HeinVerhallen/Hardware_Simulator/Documentation/Model Design Document/Second_Iteration_Realization.tex

The PCBs were ordered externally, and populated by the team. The boards are mounted on a aluminum plates to provide them with sufficient cooling. 3D models of the cell board and model board are visible in Fig. \ref{fig:pcb_top_cellboard}, Fig. \ref{fig:pcb_bottom_cellboard}
and Fig. \ref{fig:pcb_modelboard}.
\FloatBarrier
\begin{figure}[h]
    \centering
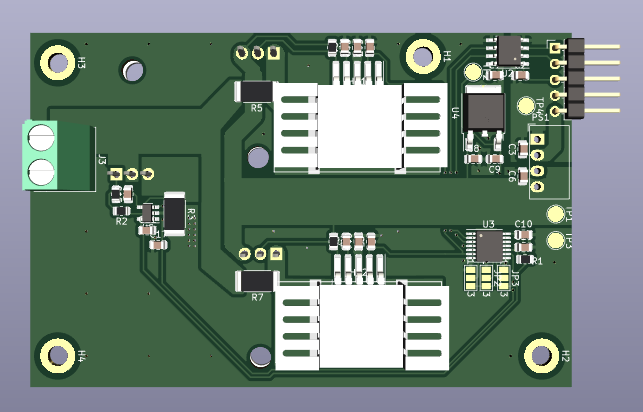
[picture p1: Documentation/Model Design Document/pcb_cell_board_top.png]
    
    \caption{PCB layout of the top of the cell board.}
    \label{fig:pcb_top_cellboard}
\end{figure}
\FloatBarrier
\begin{figure}[h]
    \centering
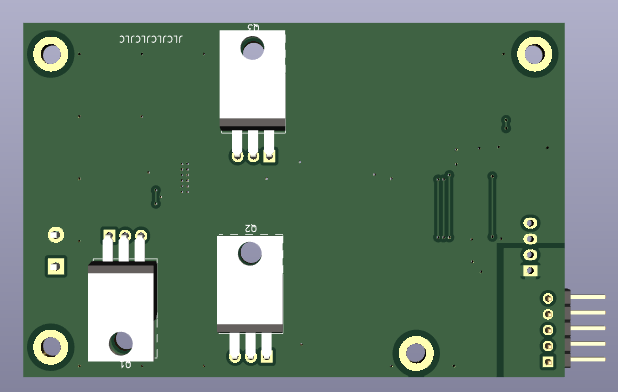
[picture p2: Documentation/Model Design Document/pcb_cell_board_bottom.png]
    
    \caption{PCB layout of the bottom of the cell board.}
    \label{fig:pcb_bottom_cellboard}
\end{figure}
\FloatBarrier
\begin{figure}[h]
    \centering
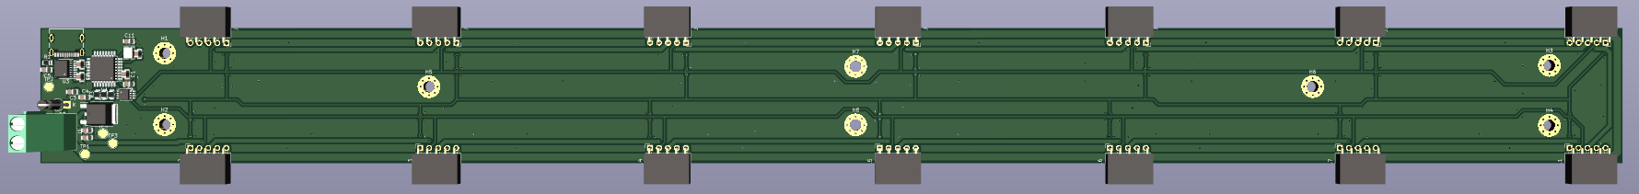
[picture p3: Documentation/Model Design Document/pcb_model_board_top.png]
    
    \caption{PCB layout of the model board.}
    \label{fig:pcb_modelboard}
\end{figure}
\FloatBarrier
