HeinVerhallen/Hardware_Simulator/Documentation/Model Design Document/First_Iteration_Hardware.tex

The first iteration board takes as an input a voltage (12 V), which
is then scaled down to 5 V to power all the on-board electronics. 
There is a USB connector and a USB interface IC, which would ensure 
being able to program the microcontroller - an ATmega328PB. For The
first iteration no software is needed, but the option was added on the 
board (with a digital potentiometer, which is explained later).

In order to make the first iteration cycle quicker and focus on 
the modular design iteration, the team included a single cell 
only in the first PCB. The cell consists of:
\begin{enumerate}
    \item A power supply section, which provides isolated 9 V and 5 V.
    \item A digital isolator - for communication for the second 
    iteration software.
    \item A high-power linear regulator - to provide the output 
    voltage, emulating discharging of the batteries.
    \item A current sink to emulate the charging of the batteries 
    consisting of an Op-Amp and a MOSFET.
    \item Potentiometers (physical but also digital ones are on 
    the board for the second iteration) - to control the voltage
    and current.
    \item Address jumpers - to distinguish each cell, when more 
    cells are added in the second iteration.
\end{enumerate}
