HeinVerhallen/Hardware_Simulator/Documentation/Model Design Document/KiCADSchematics.tex

% \FloatBarrier
\begin{figure*}[]
    \section{} \label{sec:KiCADSchematics} % For new appendix letter
    \centering
    
    \caption{Cell board full schematic.}
    \label{fig:CellBoardKiCADSchematic}
\end{figure*}

\begin{figure*}[]
    \centering
    
    \caption{Model board full schematic.}
    \label{fig:ModelBoardKiCADSchematic}
\end{figure*}
