HeinVerhallen/Hardware_Simulator/Documentation/Model Design Document/hardware_images.tex

\FloatBarrier
\begin{figure}[ht!]
    \section{}\label{sec:hardware_images}
    \centering
    
    \caption{12 A linear regulator transient response.}
    \label{fig:LT3080-1_Transient-response}
\end{figure}

\begin{figure}[ht!]
    \centering
    
    \caption{12 A linear regulator phase margin vs set point (current). The gain margin is infinite}
    \label{fig:LT3080-1_Phase-margin_VS_setpoint}
\end{figure}

\begin{figure}[ht!]
    \centering
    
    \caption{12 A linear regulator power dissipation.}
    \label{fig:LT3080-1_PowerDissipation}
\end{figure}

\begin{figure}[ht!]
    \centering
    
    \caption{12 A current sink transient response.}
    \label{fig:CurrentSinkTransient}
\end{figure}

\begin{figure}[ht!]
    \centering
    
    \caption{12 A current sink gain (blue) and fase (black) margin.}
    \label{fig:CurrentSinkPM&GM}
\end{figure}

\begin{figure}[ht!]
    \centering
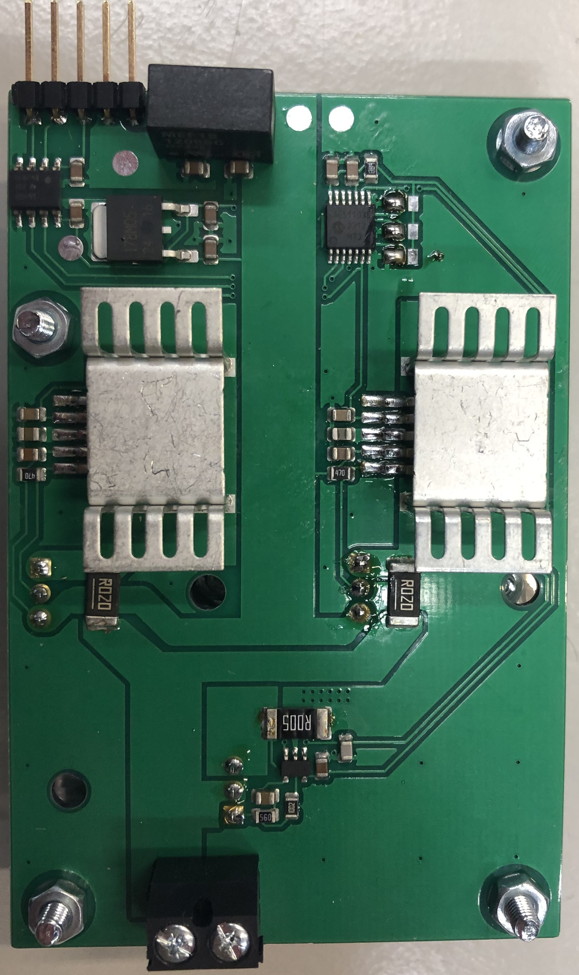
[picture p4: Documentation/Model Design Document/CellBoardTop.jpg]
    
    \caption{Top view of cell board.}
    \label{fig:CellBoardTop}
\end{figure}

\begin{figure}[ht!]
    \centering
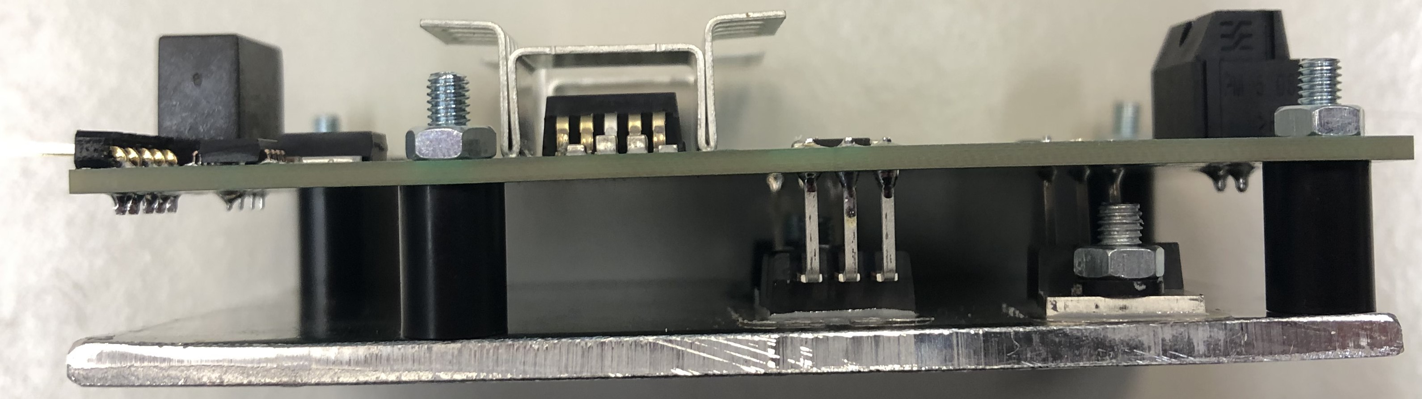
[picture p5: Documentation/Model Design Document/CellBoardSide.jpg]
    
    \caption{Side view of cell board.}
    \label{fig:CellBoardSide}
\end{figure}

\begin{figure}[ht!]
    \centering
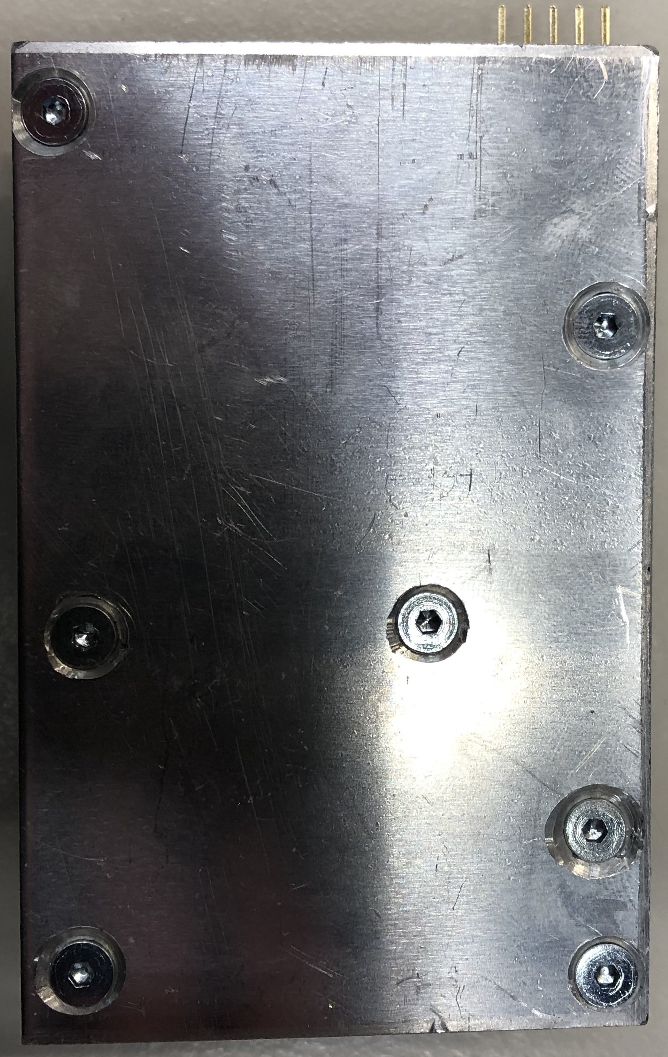
[picture p6: Documentation/Model Design Document/CellBoardBottom.jpg]
    
    \caption{Bottom view of cell board.}
    \label{fig:CellBoardBottom}
\end{figure}

\begin{figure}[ht!]
    \centering
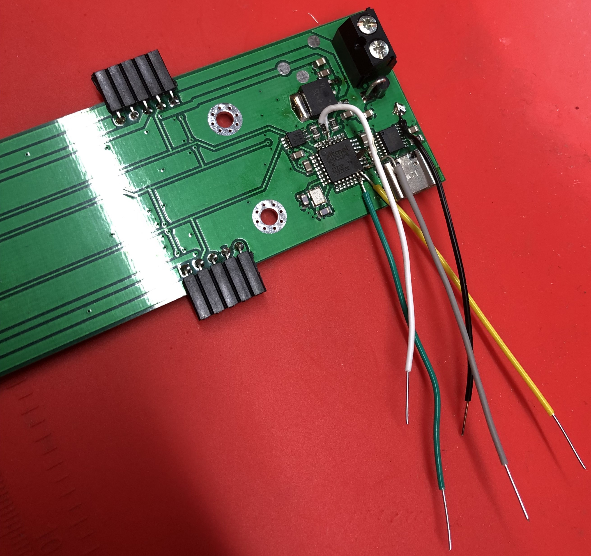
[picture p7: Documentation/Model Design Document/ModelBoardTop.jpg]
    
    \caption{Top view of model board.}
    \label{fig:ModelBoardTop}
\end{figure}

\begin{figure}[h!]
    \centering
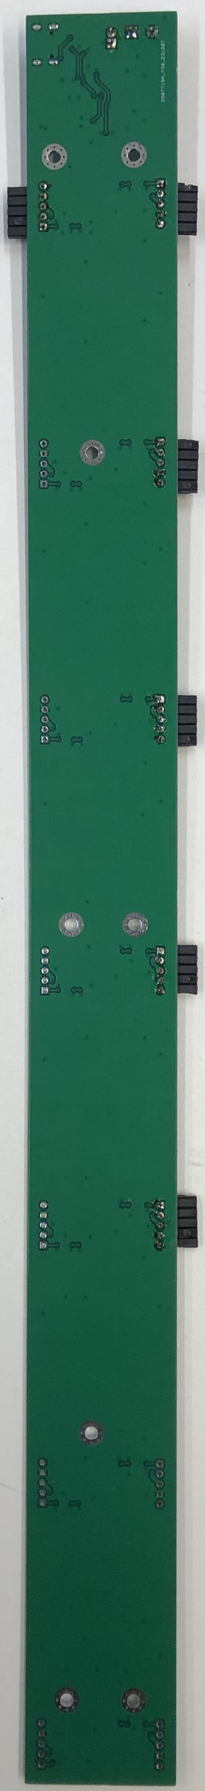
[picture p8: Documentation/Model Design Document/img/ModelBoardBottom.jpg]
    
    \caption{Bottom view of model board.}
    \label{fig:ModelBoardBottom}
\end{figure}
\FloatBarrier
