HeinVerhallen/Hardware_Simulator/Documentation/Model Design Document/First_Iteration_Architecture.tex

\begin{figure}[!th]
    \begin{center}
        
    \end{center}
    \caption{Architecture block diagram of the 1st iteration of the emulator.}
    \label{fig:1st_architecture}
\end{figure}

In Fig. \ref{fig:1st_architecture} the architecture of the first iteration 
of the battery emulator is shown.
