HeinVerhallen/Hardware_Simulator/Documentation/Model Design Document/software_flowcharts.tex

\FloatBarrier
\begin{figure}[ht!]
    \section{}\label{sec:software_flowcharts}
    \centering
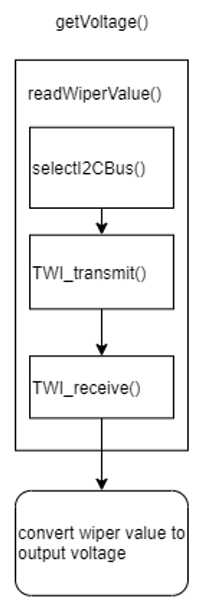
[picture p10: Documentation/Model Design Document/software_getVoltage_flow_chart.png]
    
    \caption{Flow chart of the getVoltage function.}
    \label{fig:getvoltage}
\end{figure}
\FloatBarrier
\begin{figure}[ht!]
    \centering
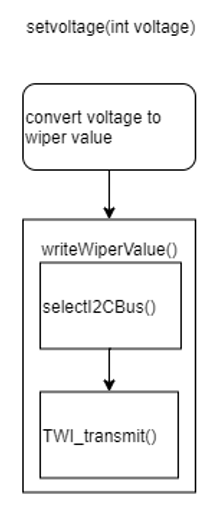
[picture p11: Documentation/Model Design Document/software_setVoltage_flow_chart.png]
    
    \caption{Flow chart of the setVoltage function.}
    \label{fig:setvoltage}
\end{figure}
\FloatBarrier
\begin{figure}[ht!]
    \centering
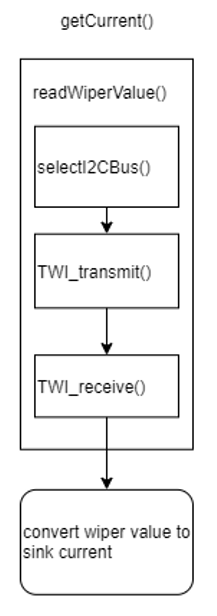
[picture p12: Documentation/Model Design Document/software_getCurrent_flow_chart.png]
    
    \caption{Flowchart of the getCurrent function.}
    \label{fig:getcurrent}
\end{figure}
\FloatBarrier
\begin{figure}[ht!]
    \centering
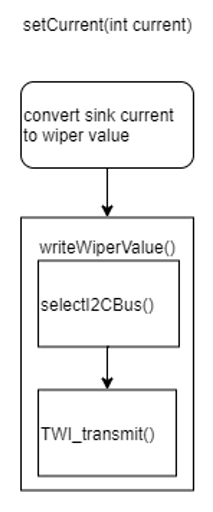
[picture p13: Documentation/Model Design Document/software_setCurrent_flow_chart.png]
    
    \caption{Flow chart of the setCurrent function.}
    \label{fig:setcurrent}
\end{figure}
\FloatBarrier
