HeinVerhallen/Hardware_Simulator/Documentation/Plan of Approach/main.tex

\documentclass[11pt, a4paper]{report}
\usepackage{graphicx}
\usepackage[table,xcdraw]{xcolor}
\usepackage{geometry}
\usepackage{float}
\usepackage{authblk}
\usepackage{anyfontsize}
\usepackage[document]{ragged2e}
\usepackage{titlesec}
\usepackage[parfill]{parskip}
\usepackage{color}   %May be necessary if you want to color links
\usepackage{hyperref}
\usepackage{caption}
\usepackage{tabularx}
\usepackage{longtable}
\usepackage{blindtext}
\usepackage{pdflscape}
\usepackage{multirow}
\usepackage{booktabs}
\hypersetup{
    colorlinks=true, %set true if you want colored links
    linktoc=all,     %set to all if you want both sections and subsections linked
    linkcolor=black,  %choose some color if you want links to stand out
}
\titleformat{\chapter}[hang] 
{\normalfont\huge\bfseries}{\chaptertitlename\ \thechapter:}{1em}{} 
\geometry{left=2.5cm,right=2.5cm,top=2.5cm,bottom=2.5cm}
\graphicspath{ {./images/} }

% Handy link: https://artofproblemsolving.com/wiki/index.php/LaTeX:Layout

% CHECK https://www.youtube.com/watch?v=ZYvS52511oQ FOR INFO ON SETTINGS FOR biblatex

\begin{document}
\pagestyle{empty}
\centering
\fontsize{2cm}{2cm}\selectfont{Plan of Approach} \\
\vspace{2mm}
\fontsize{1cm}{1cm}\selectfont Hardware Simulator \\
\vspace{2mm}
\large Project S7\\
\normalsize
\vspace{4cm}
% \includegraphics[width=\linewidth]{3DR_P1_Perspective.png}\\
\vfill
\normalsize Hein Verhallen \\
Nikola Panchev \\
Robin van den Dungen \\
Wyatt Southard \\
Youri Tils \\
Fontys Hogescholen, De Rondom 1, 5612 AP Eindhoven \\
\today

\begin{justify}

\newpage
\tableofcontents
\thispagestyle{empty}

\listoffigures
\thispagestyle{empty}

\listoftables
\thispagestyle{empty}

\newpage
\pagestyle{plain}
\setcounter{page}{1}

\chapter*{Abbreviation List}

\begin{table}[!h]
	\centering
\begin{tabular}{|c|c|}
	\hline
\textbf{Abbreviation} & \textbf{Explanation}        \\ \hline
BMS                   & Battery management system    \\ \hline
Li-ion	              & Lithium-ion    \\ \hline
\end{tabular}
\caption{List of commonly used Abbreviations}
\label{Abbreviation list}
\end{table}

\chapter{Background}
	\input{Background}

\chapter{Project result}
	\input{Projectresult}
	
\chapter{Project activities}
	\input{Projectactivities}

\chapter{Project boundaries}
	\input{Projectboundaries}
	
\chapter{Milestones}
	\input{Milestones}

\chapter{Quality assurance}
	\input{Qualityassurance}

\chapter{Project organization}
	\input{Projectorganization}

% \begin{landscape}
	\chapter{Planning}
		\input{Planning}
% \end{landscape}

\chapter{Cost-benefit overview}
	\input{Costbenefitoverview}

\chapter{Risk Analysis}
	\input{Riskanalysis}

\chapter{Appendix A: requirements}
	\input{Appendix_A_requirements.tex}

% Bibliography with heading so it pops up in the table of contents (i don't know why but this is how it works)
% \printbibliography[
% heading=bibintoc,
% title={Bibliography}
% ]
	\end{justify}
\end{document}
