HeinVerhallen/Hardware_Simulator/Documentation/Plan of Approach/Projectresult.tex

\begin{figure}[ht]
    \centering
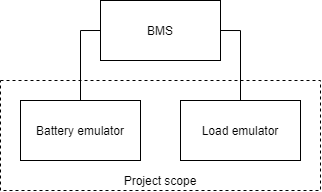
[picture p14: Documentation/images/System_context_diagram.png]
    
    \caption{System context diagram}
    \label{fig:system_context_diagram}
\end{figure}

The goal of this project is to design, built and test a battery pack emulator and (optionally) a load emulator that can be used to test a BMS (see figure \ref{fig:system_context_diagram}). This battery pack emulator should in the first design iteration be capable of emulating a battery pack with Li-ion cell characteristics. In order to emulate a Li-ion cell correctly it should be possible to emulate both charging and discharging of the Li-ion cell. 

Because the project team members are not yet experts in the field of designing battery pack emulators for BMS testing, it is chosen to design the battery pack emulator in iterations. In the first design iteration a battery pack emulator circuit will be designed which emulates the characteristics of a Li-ion battery pack. This battery pack emulator consists of two Li-ion cell emulators which are capable of charging and discharging. The voltages of each emulated cell are adjusted by a mechanical variable resistor. Each emulated cell has a voltage and current range that is 20\% larger than the safe operating area of a Li-ion cell.

In the second design iteration software will be added to the battery emulator circuit to control the voltages of each emulated cell via software. Also the temperature will be emulated in the battery pack emulator. The third design iteration consists of expanding the amount of emulated cells in the emulated battery pack to 14 cells. In the fourth design iteration a load emulator will be designed to test the BMS under different load conditions. This load emulator is capable of emulating electronics and motors. 

At the end of the project it is expected that a battery pack emulator and optionally a load emulator is delivered. And if the planning allows it, a research report on existing battery and load emulators and the requirements for future battery and load emulators is delivered.

\section{Research questions}
In order to acquire functional requirements the following research questions have been derived:

\begin{itemize}
    \item What is the safe operating area for Li-ion cells?
    \item How do existing battery emulators work?
    \item How do existing load emulators work?
\end{itemize}

\section{Requirements}
For this project the following non-functional requirements with their functional requirements have been specified (see figure \ref{fig:functional_and_non-functional_requirements} in Appendix). These requirements can be changed according to research results.
