HeinVerhallen/Hardware_Simulator/Documentation/Plan of Approach/Projectactivities.tex

This chapter will detail the activies that will take place during the project and are listed below. 

\begin{enumerate}
    \item Planning 
    \item Documenting
    \item 1st Iteration of Emulator
    \item 2nd Iteration of Emulator
    \item 3rd Iteration of Emulator
    \item 4th Iteration of Emulator
\end{enumerate}

\begin{itemize}
    \item Documenting
    \begin{itemize}
    \item Create SRD
    \item Create SDD
    \item Create MDD
    \item Create research paper on the created emulator 
    \item Create a research paper on existing emulators(optional)
    \end{itemize}

    \item 1st Iteration of Emulator
    \begin{itemize}
        \item Designing
        \begin{itemize}
            \item Research existing battery emulators 
            \item Research characteristics of lithium battery cells 
            \item Integrate results from research
        \end{itemize}
        \item Realization
        \begin{itemize}
            \item Create PCB
        \end{itemize}
        \item Testing
        \begin{itemize}
            \item Verify battery emulator
        \end{itemize}
    \end{itemize}

    \item 2nd Iteration of Emulator
    \begin{itemize}
        \item Designing 
        \begin{itemize}
            \item Design hardware
            \begin{itemize}
                \item Research different cell topolgies 
                \item Research different capacity behaviors 
                \item Research different chemistry behaviors
            \end{itemize}
            \item Design firmware
        \end{itemize}
        \item Realization
        \begin{itemize}
        \item Create PCB
        \item Program PCB
        \end{itemize}
        \item Testing
        \begin{itemize}
            \item Verify hardware
            \item Verify software 
            \begin{itemize}
                \item Verify capacity behavior changes
                \item Verify chemistry behavior changes
            \end{itemize}
        \end{itemize}
    \end{itemize}

    \item 3rd Iteration of Emulator 
    \begin{itemize}
        \item Designing 
        \begin{itemize}
            \item Design hardware
            \begin{itemize}
                \item Add 12 cells
            \end{itemize}
        \end{itemize}
        \item Realization
        \begin{itemize}
        \item Create PCB
        \item Program PCB
        \end{itemize}
        \item Testing
        \begin{itemize}
            \item Verify hardware
            \item Verify software 
        \end{itemize}
    \end{itemize}

    \item 4th Iteration of Emulator (optional)
    \begin{itemize}
        \item Designing 
        \begin{itemize}
            \item Design hardware
            \begin{itemize}
                \item Research different load behaviors 
            \end{itemize}
            \item Design Firmware
            \begin{itemize}
                \item Control load emulator
            \end{itemize}
        \end{itemize}
        \item Realization
        \begin{itemize}
        \item Create PCB
        \item Program PCB
        \end{itemize}
        \item Testing
        \begin{itemize}
            \item Verify hardware
            \item Verify software 
            \begin{itemize}
                \item Verify load behavior changes
                \item Verify communication between load and emulator
                \end{itemize}
        \end{itemize}
    \end{itemize}

\end{itemize}
