HeinVerhallen/Hardware_Simulator/Documentation/Plan of Approach/Milestones.tex

\begin{enumerate}
    \item Reports
    \begin{enumerate}
        \item SRD
        \item SDD
        \item MDD
        \item Final research paper on created module
        \item Research paper on existing battery emulators
    \end{enumerate}
    \item Designs
    \begin{enumerate}
        \item Hardware Designs
        \begin{enumerate}
            \item 1st iteration of battery emulator with 2 cells based on the NXP model
            \item 2nd iteration of battery emulator including digital battery control 
            \item 3rd iteration of battery emulator including 12 additional cells 
            \item 4th iteration of battery emulator including a load emulator
        \end{enumerate}
        \item Firmware Designs
        \begin{enumerate}
            \item Battery emulator firmware of the 2nd iteration
            \item Load emulator firmware (optional)
        \end{enumerate}
    \end{enumerate}
    \item Realizations
    \begin{enumerate}
        \item Hardware
        \begin{enumerate}
            \item PCBs
        \end{enumerate}
        \item Firmware
        \begin{enumerate}
            \item Program battery emulator
            \item Program load emulator (optional)
        \end{enumerate}
    \end{enumerate}
\end{enumerate}
