HeinVerhallen/Hardware_Simulator/Documentation/Mid-term_presentation/Mid-term_presentation.pptx

## BMS-tester S7

Hein Verhallen, Nikola Panchev, Robin van den Dungen, Wyatt Southard & Youri Tils

## Contents

## …

## Questions
