HeinVerhallen/Hardware_Simulator/Documentation/Model Design Document/img/classDiagram.pdf

CellEmulator

+ Voltage: double
+ Current: double
+ I2Cbus: uint8_t
+ potAddress1: uint8_t
+ potAddress2: uint8_t

Public:
+ constructor(uint8_t, uint8_t) + getVoltage(): double
+ getCurrent(): double
+ setVoltage(double): int
+ setCurrent(double): int
Private:
+ writeWiperValue(uint8_t,uint8_t) + selectI2Cbus(): void
