HeinVerhallen/Hardware_Simulator/Planning Hardware emulator.xlsx

 |  |  |  |  |  | Project week number
Project phase | Task | Sub task | Assigned to 1 | Assigned to 2 | Progress | 1 | 2 | 3 | 4 | 5 | 6 | 7 | 8 | 9 | 10 | 11 | 12 | 13 | 14 | 15 | 16 | 17 | 18 | 19 | 20 | Current week | 28
Documentation | PoA |  | Everyone
Documentation | SRD |  | Everyone
Documentation | SDD |  | Everyone
Documentation | MDD |  | Everyone
Research | Researching | Research different cell topologies
Research | Researching | Research different capacity behaviors
Research | Researching | Research different chemistry behaviors
Research | Researching
Research | Researching
Research | Researching
Research | Researching
Research | Researching
Research | Researching
Research | Researching
Architecture
Architecture
Architecture
Architecture
Architecture
Architecture
Architecture
Development
Development
Development
Development
Development
Development
Development
Development
Development
Development
Development
Development
Development
Development
Development
Development
Development
Development
Development
Development
Development
Development
Development
Development
Development
Development
Development
Development
Development
Development
Development
Assembly
Assembly
Assembly
Assembly
Assembly
Validation
Validation
