HeinVerhallen/Hardware_Simulator/Documentation/Plan of Approach/Functional and non-functional requirements.xlsx

NF ID | Non-functional | Design iteration | F ID | Functional
1 | Battery pack emulator is able to emulate Li-ion characteristics | 1 | 1.1 | The maximum voltage of the battery pack emulator is 80V
 |  |  | 1.2 | The battery pack emulator has a peak power of 13.44kW (see 10.1)
 |  |  | 1.3 | The battery pack emulator has a continuous power of 112W (see 10.1)
2 | Battery pack emulator consists of two emulated Li-ion cells | 1 | 2.1 | The first iteration of the battery pack emulator consists of two emulated Li-ion cells
3 | Battery pack emulator is able to emulate charging and discharging of Li-ion cell | 1 | 3.1 | The emulated cell is able to deliver current (see 5.2 and 5.3)
 |  |  | 3.2 | The emulated cell is able to sink current (see 5.4 and 5.5)
 |  |  | 3.3 | A linear regulator is used to generate the specified voltages (see 5.1)
4 | The voltages of each emulated cell can be adjusted separately via hardware | 1 | 4.1 | The cell voltages can be changed by a mechanical variable resistor
5 | Each emulated cell has a voltage and current range that is 20% larger than the safe operating area of a Li-ion cell | 1 | 5.1 | The emulated cell has a voltage range of 2.48 to 5.04 V
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
