HeinVerhallen/Hardware_Simulator/Documentation/Plan of Approach/Appendix_A_requirements.tex

\begin{figure}[ht!]
    \centering
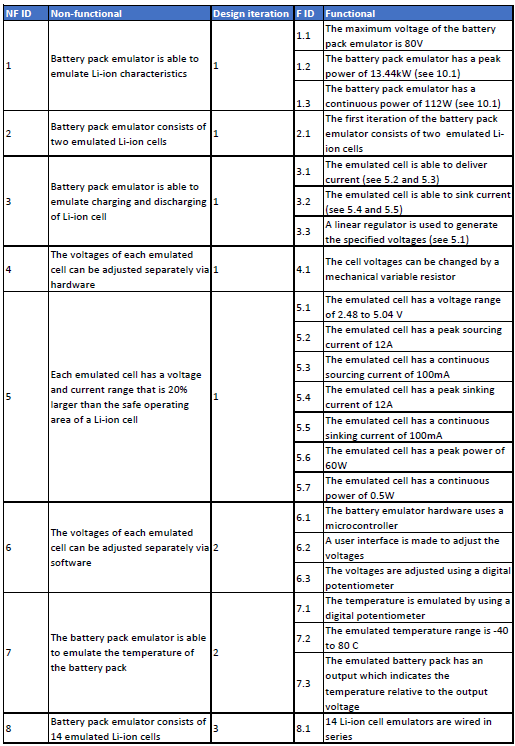
[picture p21: Documentation/Plan of Approach/images/Functional_non-functional_requirements_p1.png]
    
\end{figure}
\newpage

\begin{figure}[ht!]
    \centering
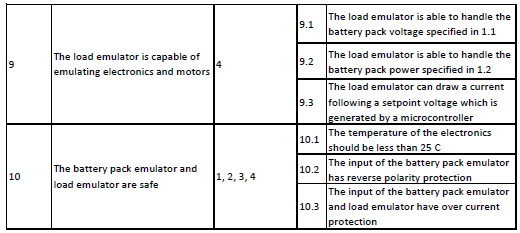
[picture p22: Documentation/Plan of Approach/images/Functional_non-functional_requirements_p2.png]
    
    \caption{Functional and non-functional requirements}
    \label{fig:functional_and_non-functional_requirements}
\end{figure}
