HeinVerhallen/Hardware_Simulator/Documentation/Plan of Approach/Planning.tex

\begin{figure}[ht!]
    \centering
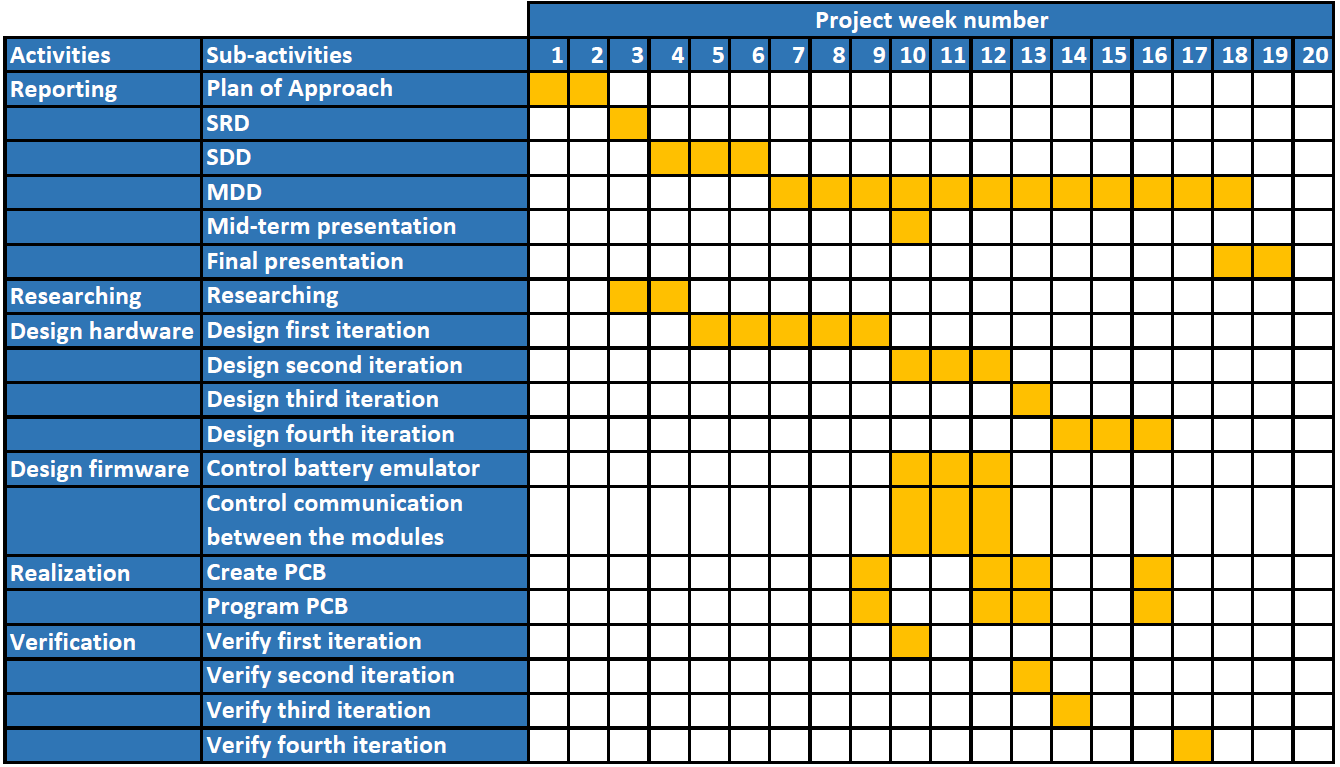
[picture p23: Documentation/Plan of Approach/images/Broad_planning.png]
    
    \caption{planning}
    \label{tab:planning}
\end{figure}
