HeinVerhallen/Hardware_Simulator/Documentation/Plan of Approach/Qualityassurance.tex

For good quality deliverables it is necessary that all team members are using the same tools and environments. Therefore the tools and environments are listed down below:

The documentation will be written in LaTeX using the following tools:
\begin{itemize}
    \setlength\itemsep{-0.3em}
    \item The editor will be VSCode.
    \item The compiler will be MiKTeX
\end{itemize}

The coding will be done using the following tools:
\begin{itemize}
    \item VSCode
    \item PlatformIO extension
\end{itemize}

The design and simulation of electronic circuits will be made using the following tools:
\begin{itemize}
    \item LTspice for simulation
    \item Altium for PCB design
\end{itemize}

In order to make sure that everyone can work simultaneously on documents and code the team wil utilize Git with an online repository hosted on GitHub.
