HeinVerhallen/Hardware_Simulator/Simulations/Linear-regulator/Period1/Ananlyse_PREG.docx

V1:

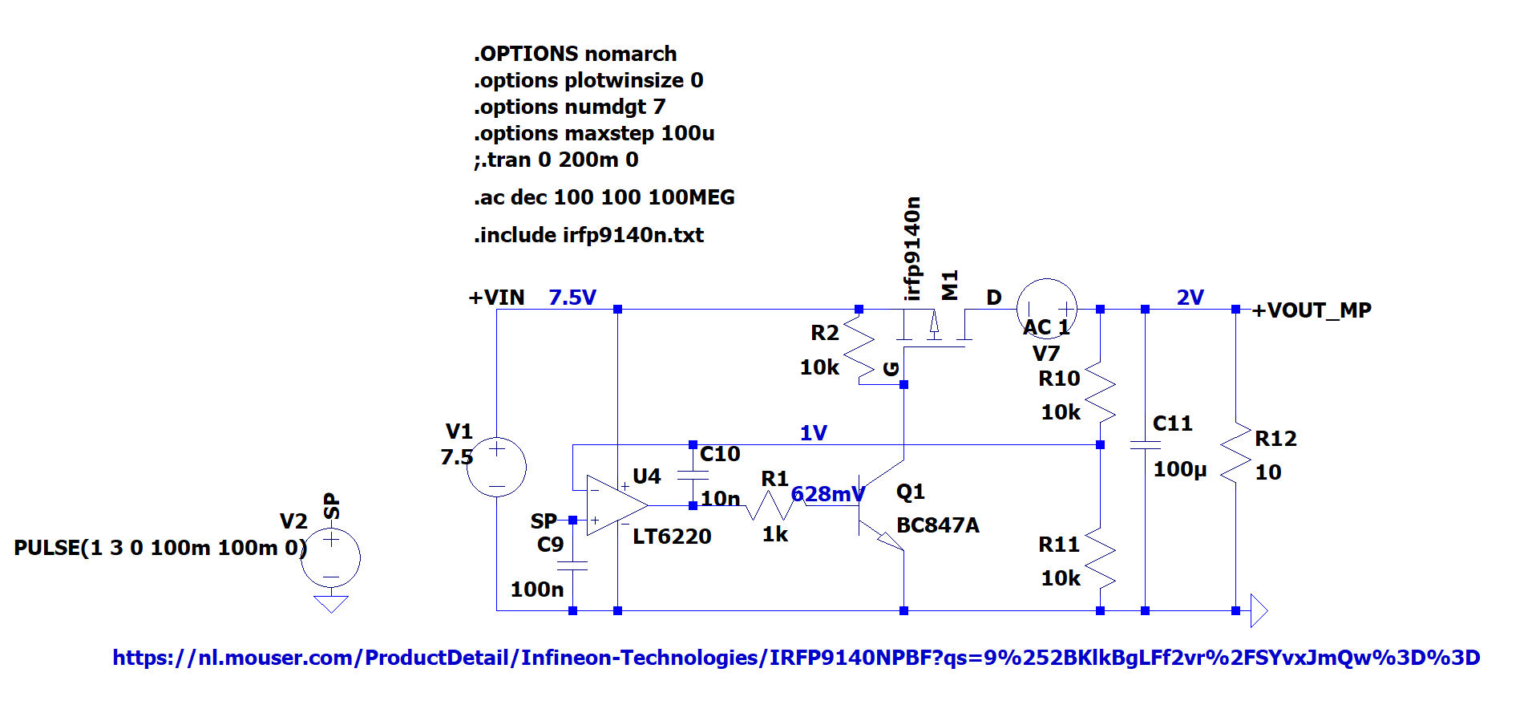
[picture p24: figure]
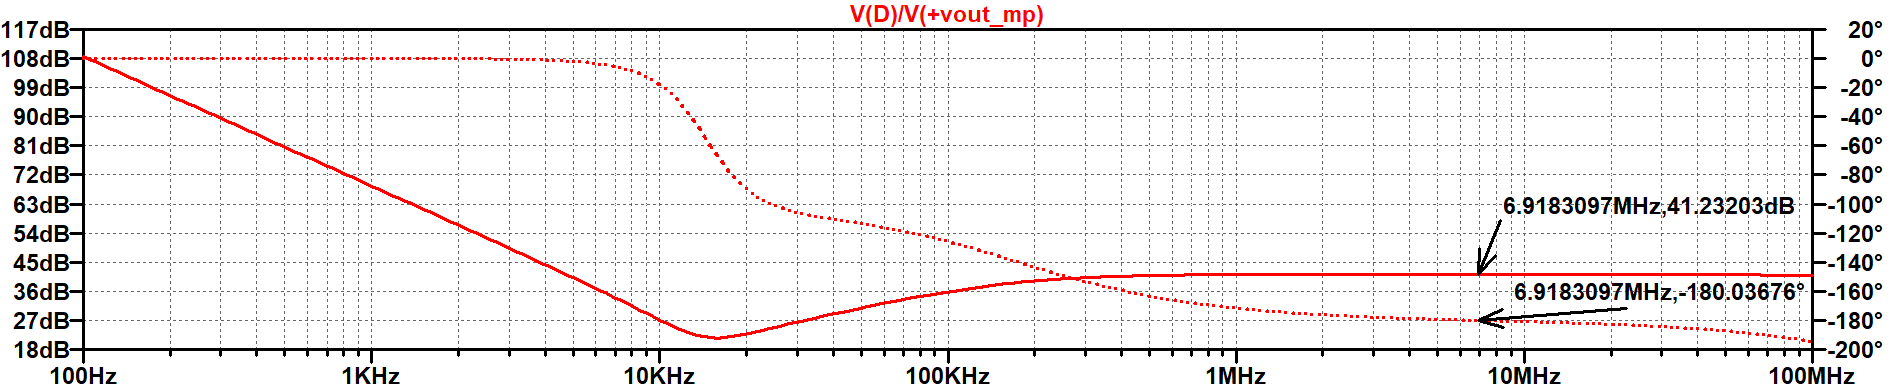
[picture p25: figure]

V2:

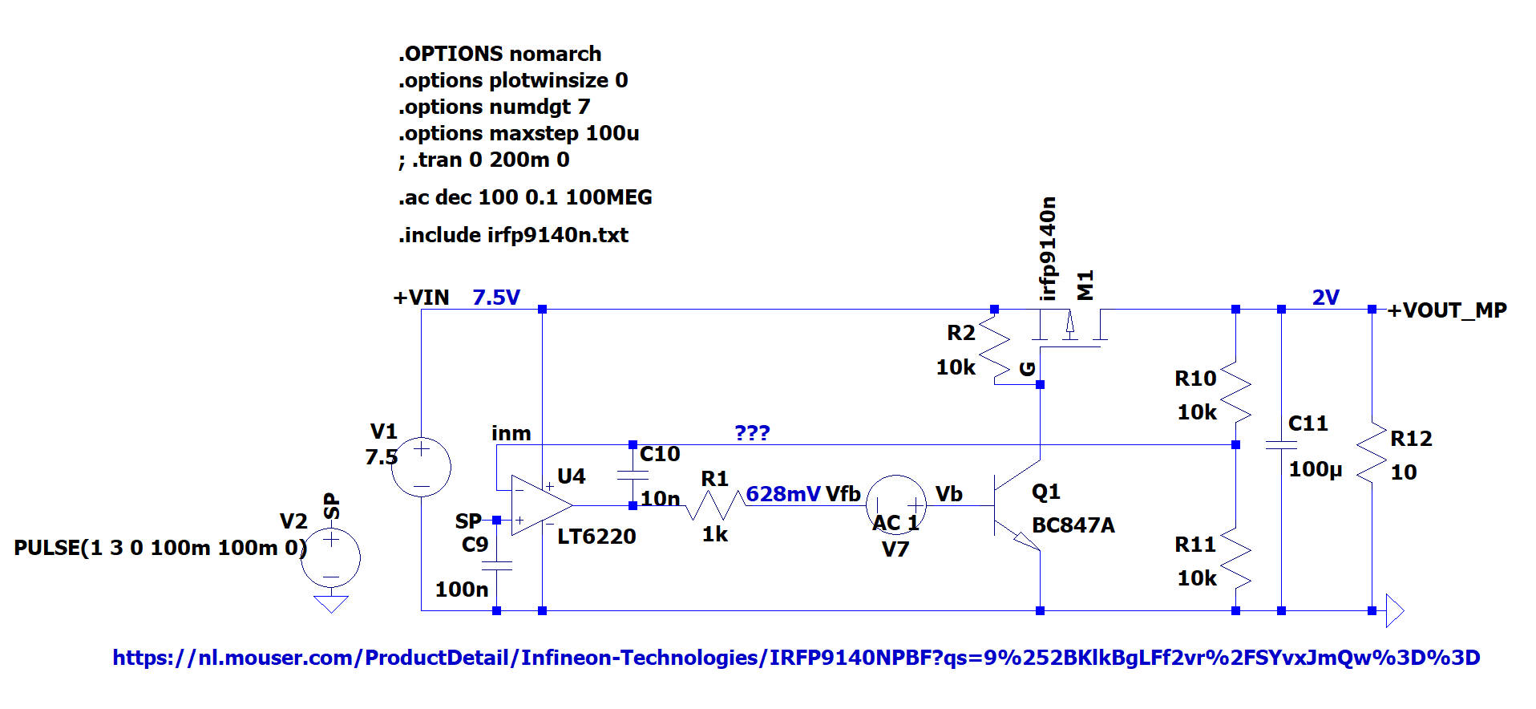
[picture p26: figure]
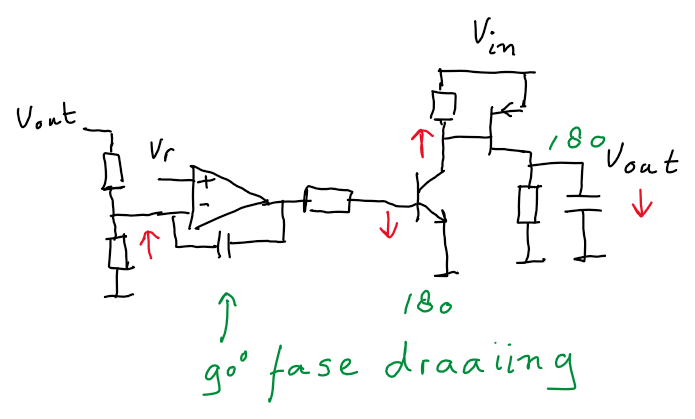
[picture p27: figure]
C:\Users\882920\AppData\Local\Microsoft\Windows\INetCache\Content.MSO\7C2EDA0D.tmp
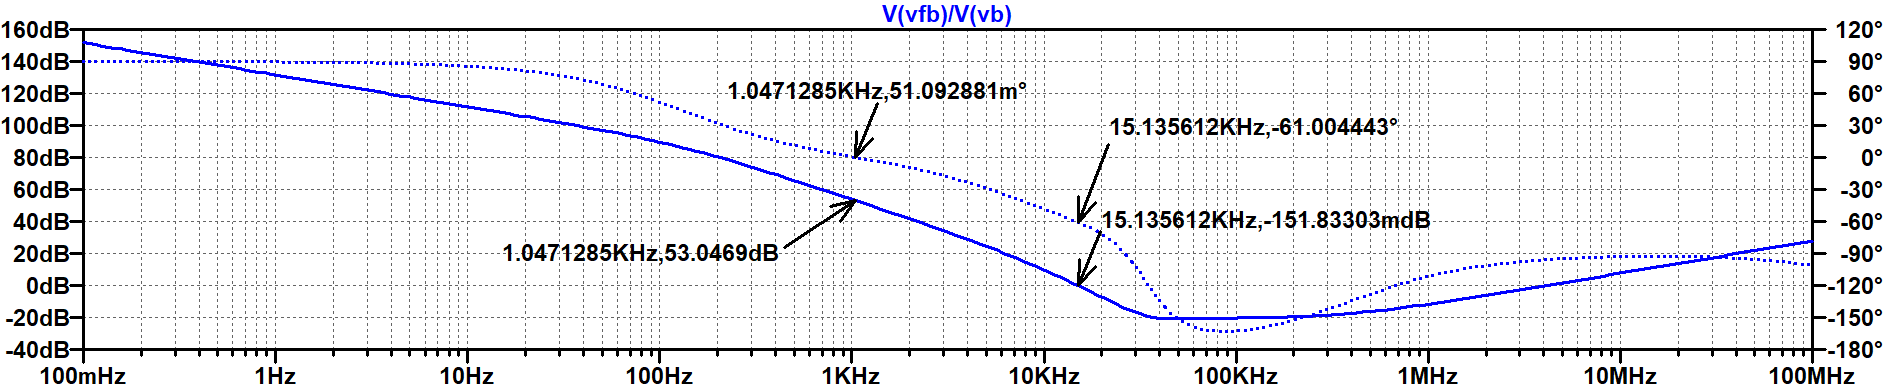
[picture p28: figure]

Verschillende tussen overdrachten:

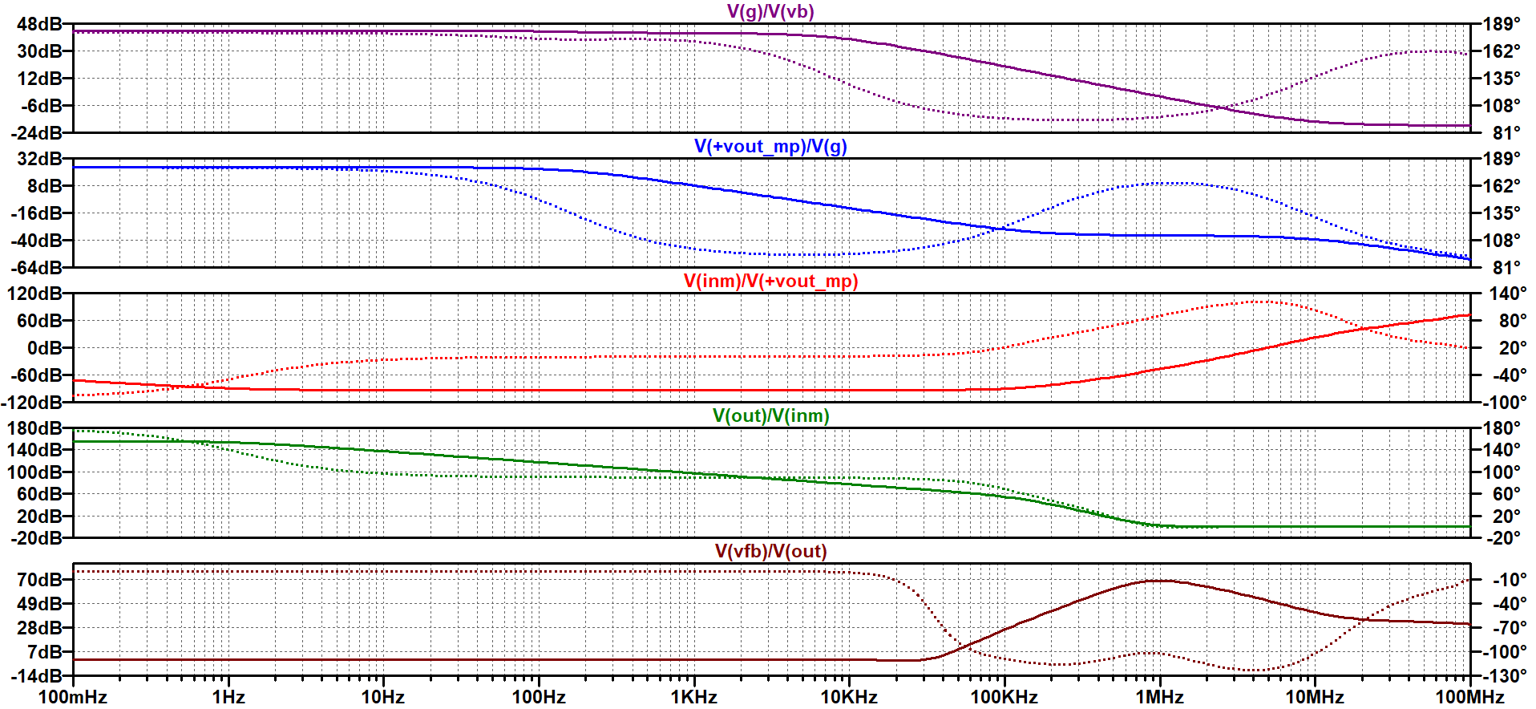
[picture p29: figure]

V(out)/V(inm) is dominant, daarna V(+vout_mp)/V(g) en vervolgens V(g)/V(vb).

3e orde, te veel fase draaiing.

V3: Zonder C10

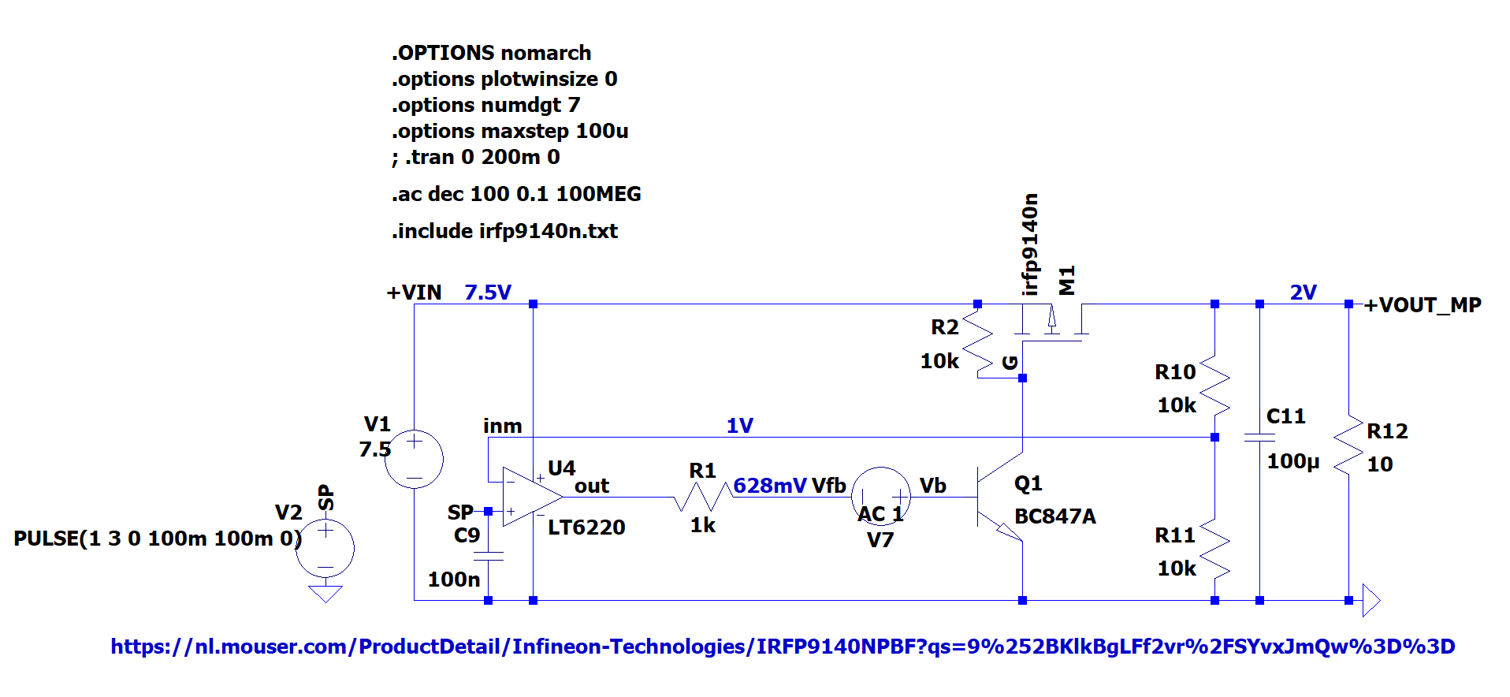
[picture p30: figure]
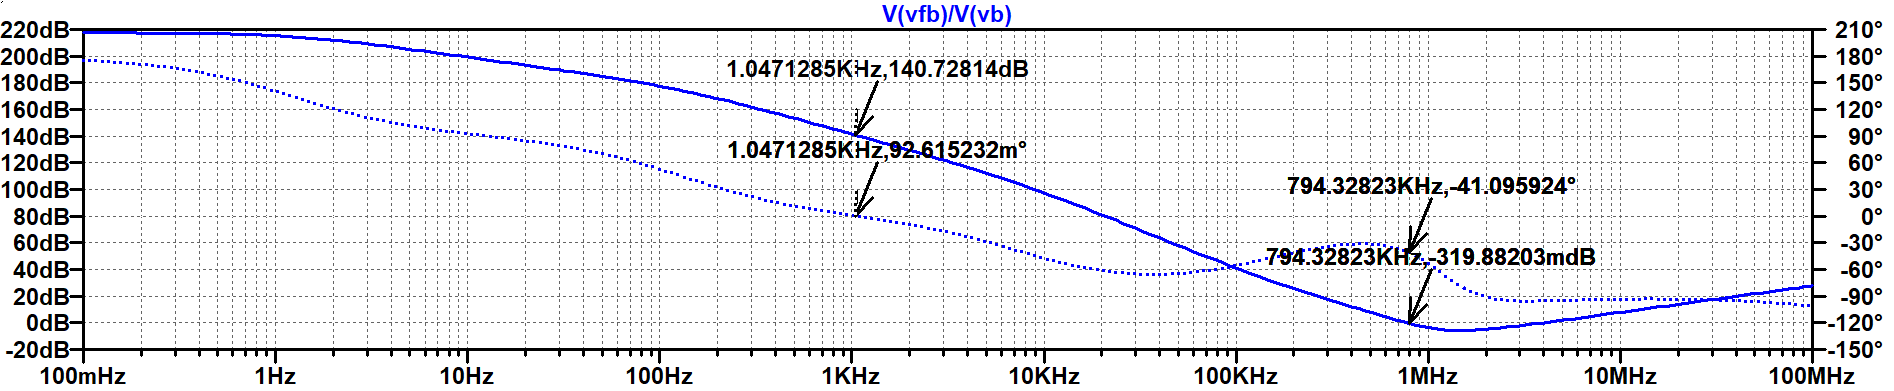
[picture p31: figure]

Te veel loopgain.

Verschillende tussen overdrachten:

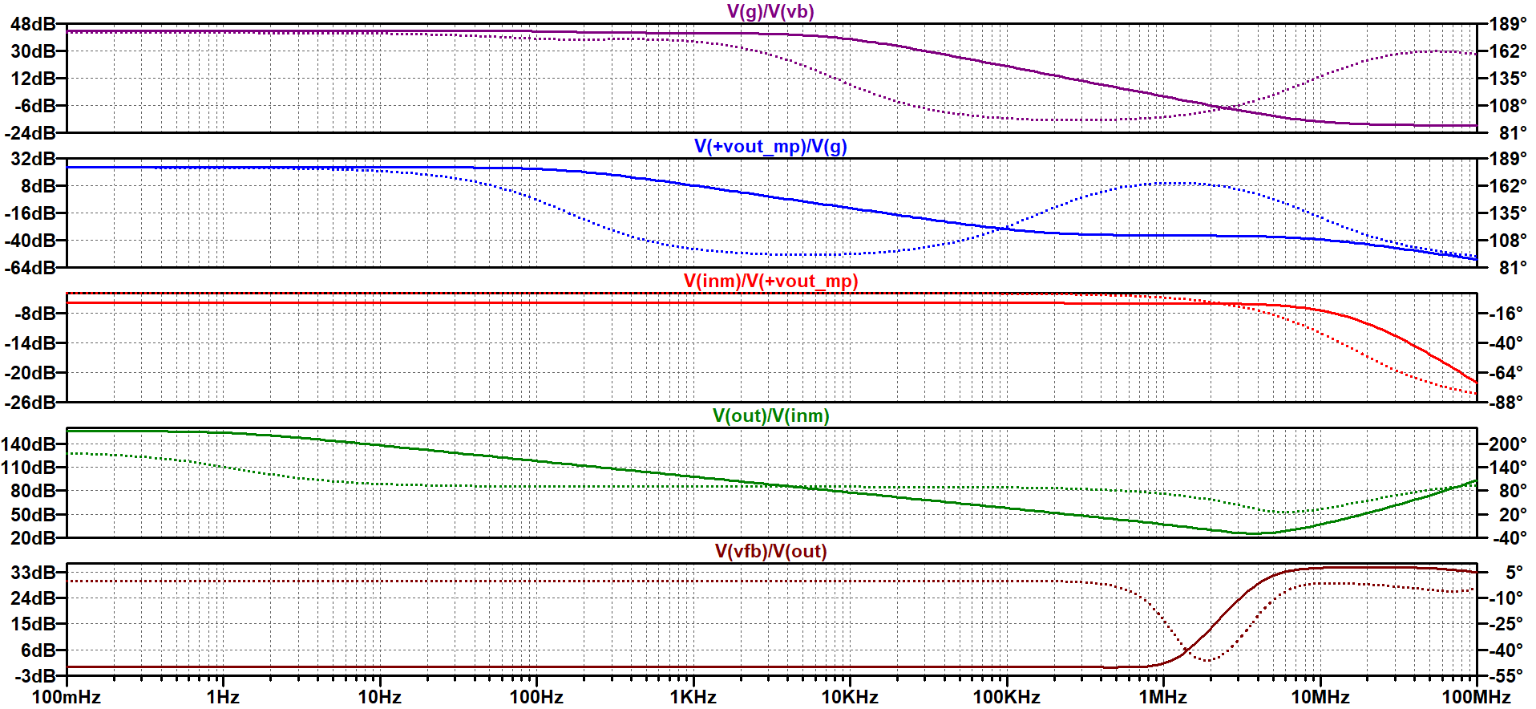
[picture p32: figure]

V4:

Transistor verwijderd.

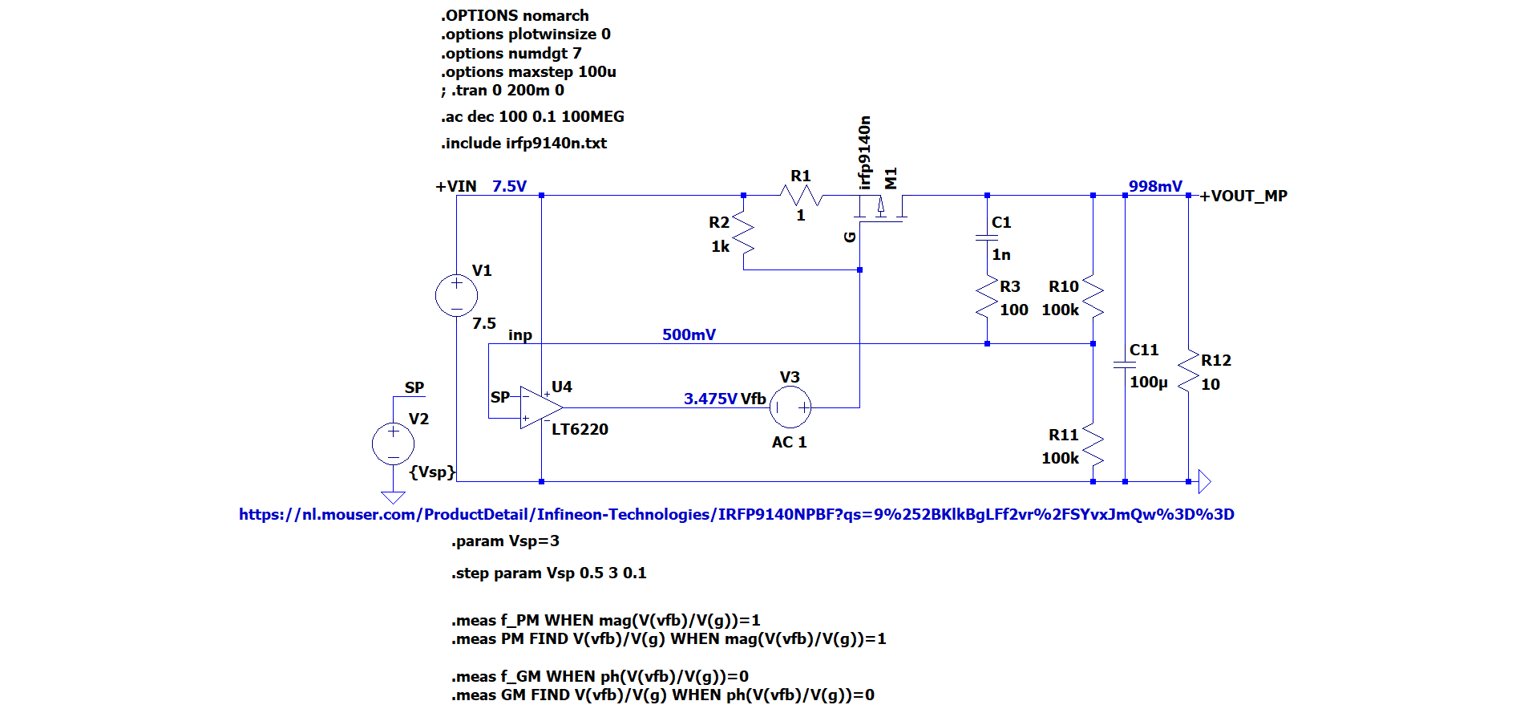
[picture p33: figure]

Figuur 1: Stabiliteitsanalyse met variërend set-point (0.5 – 3V)

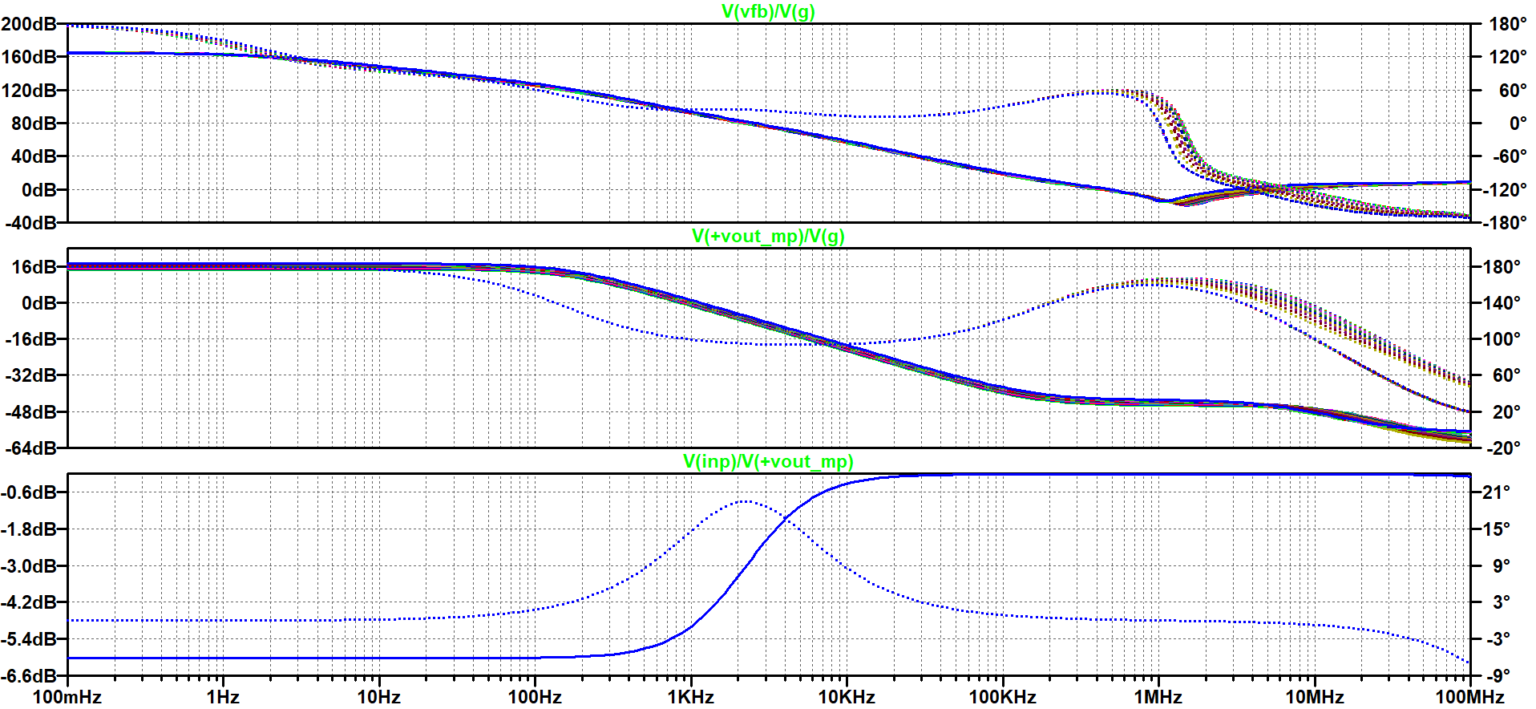
[picture p34: figure]

Figuur 2: Simulatie resultaat van setup weergegeven in Figuur 1

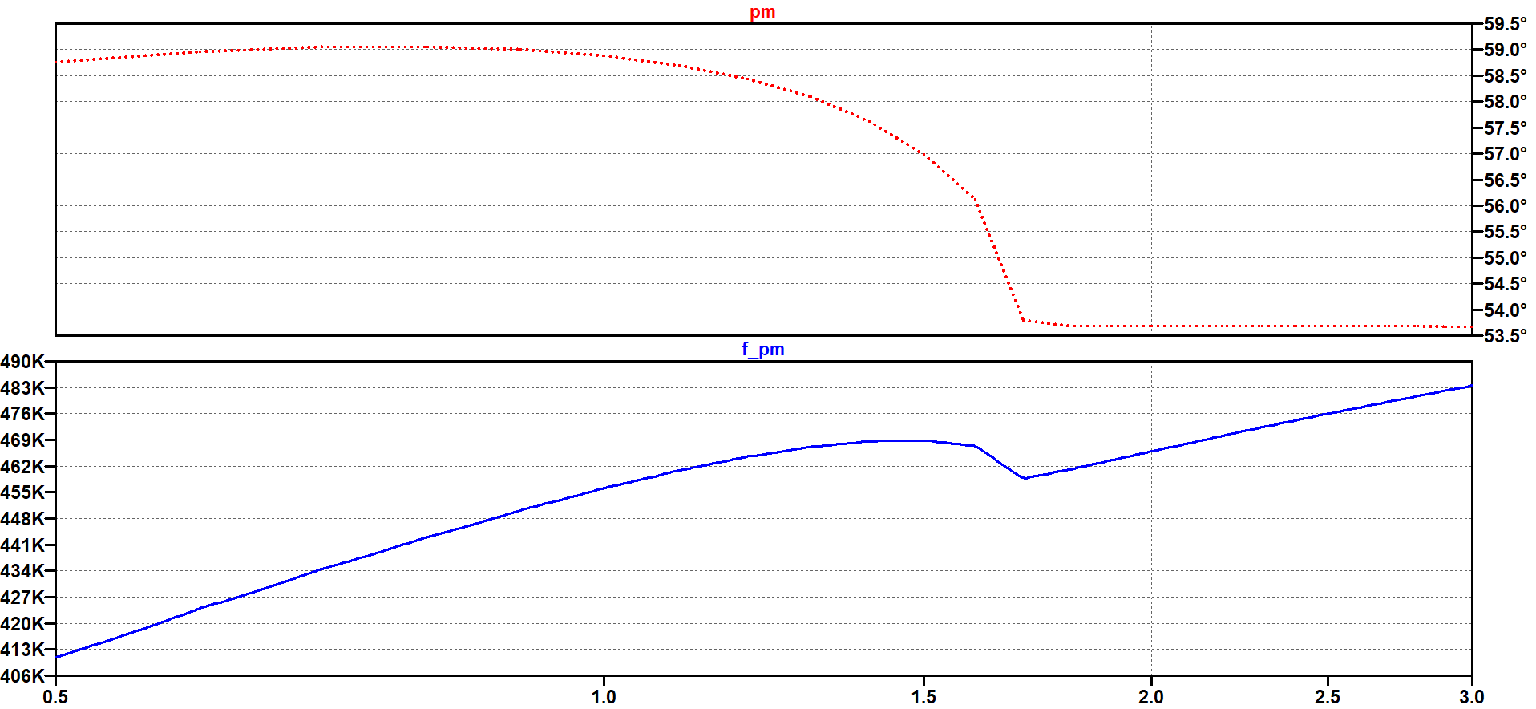
[picture p35: figure]

Figuur 3: Fase marge en bijbehorende frequentie

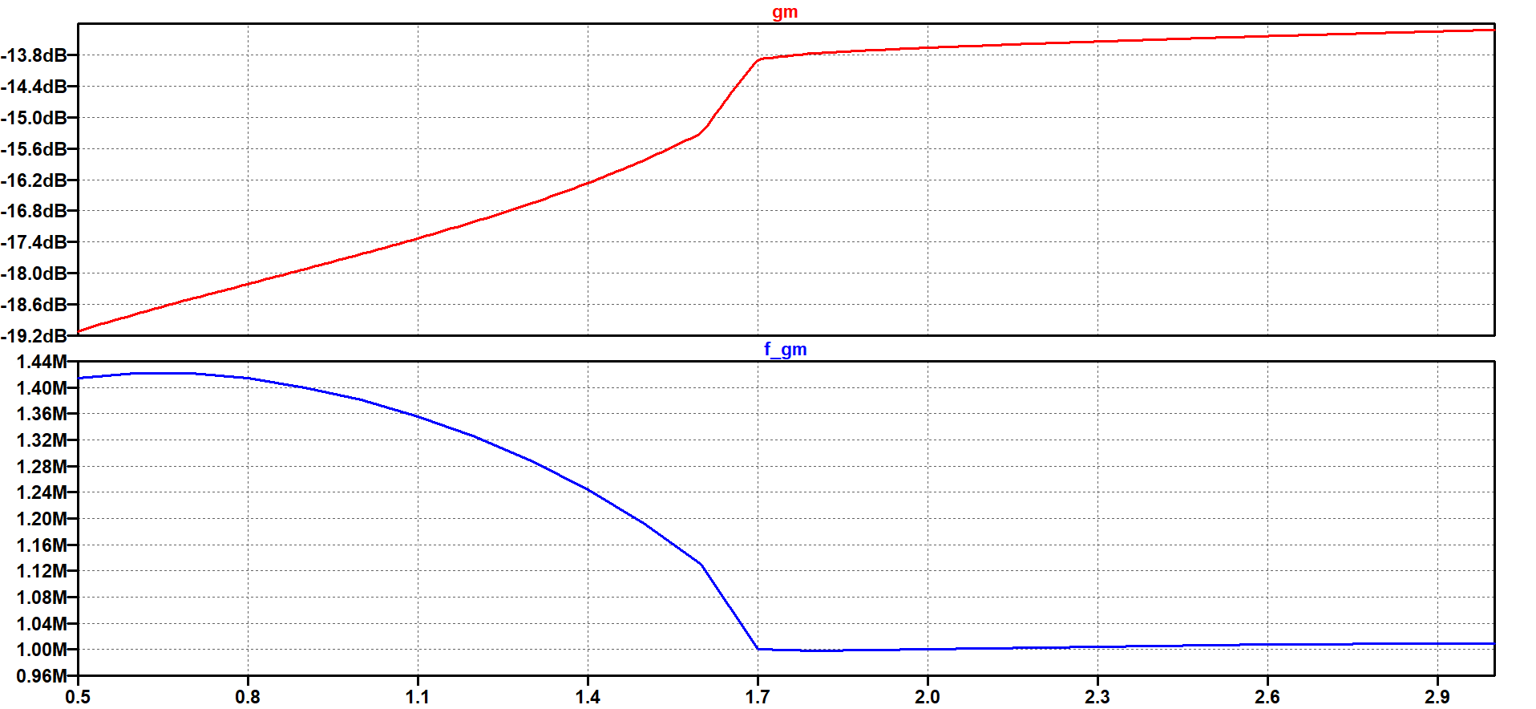
[picture p36: figure]

Figuur 4: Versterkings marge en bijbehorende frequentie

Invloed van ESR.

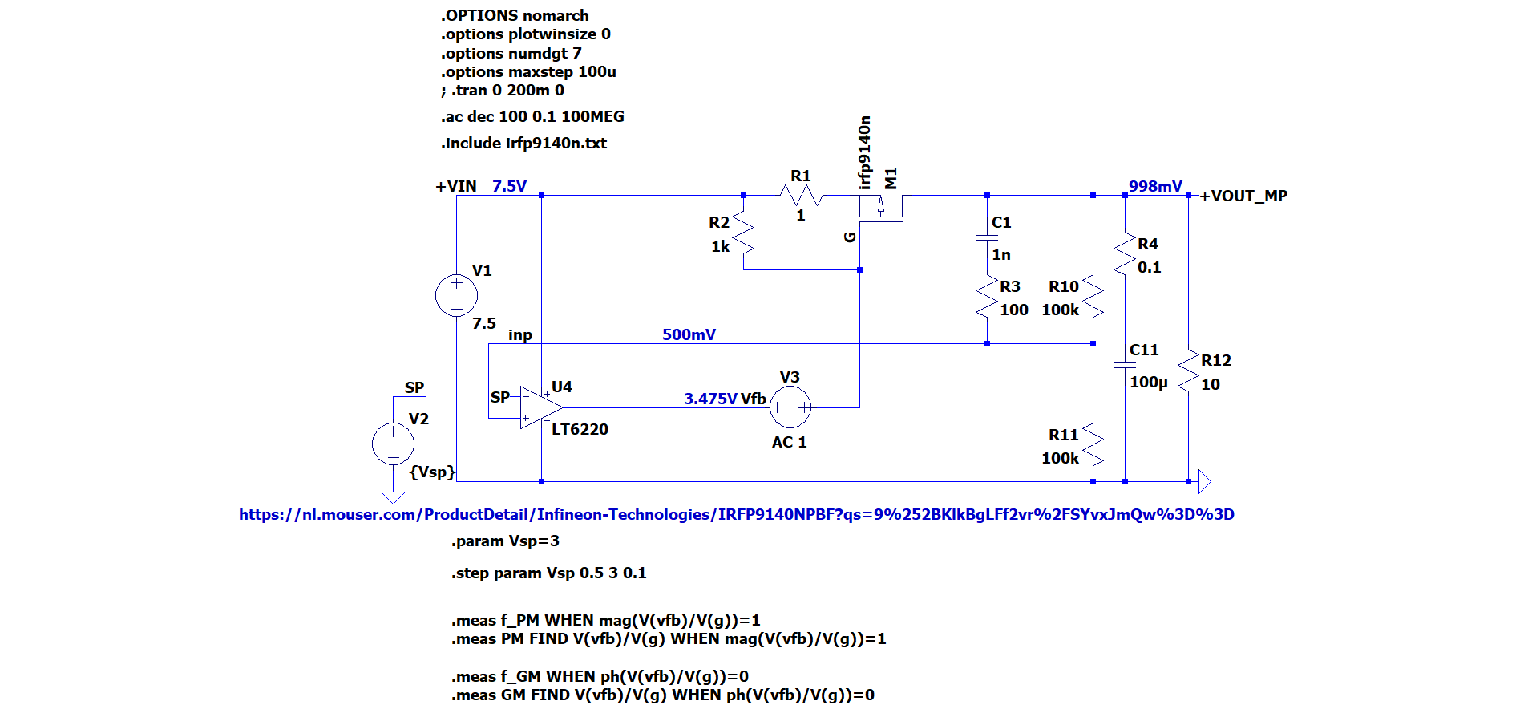
[picture p37: figure]

Figuur 5: Stabiliteitsanalyse met ERS en variërend set-point (0.5 – 3V)

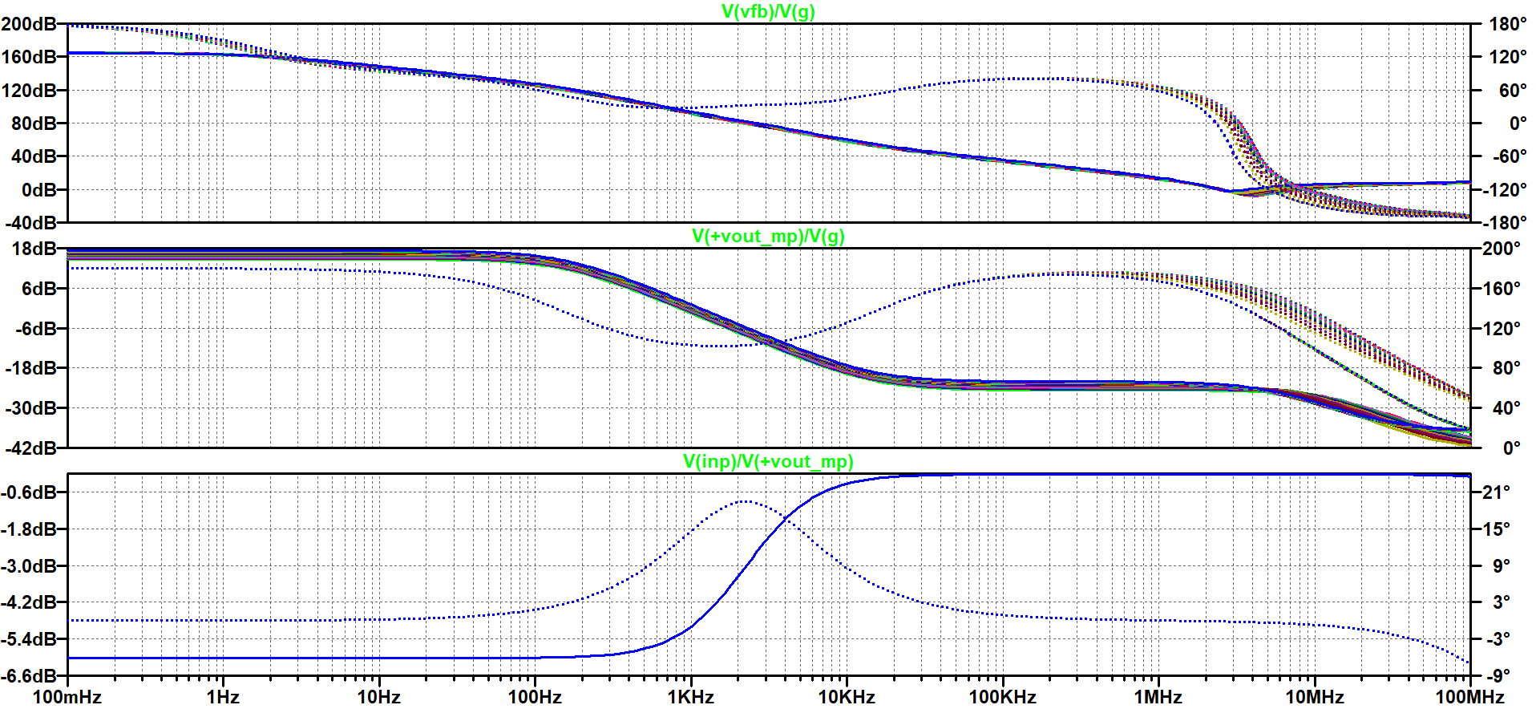
[picture p38: figure]

Figuur 6: Simulatie resultaat van setup weergegeven in Figuur 5

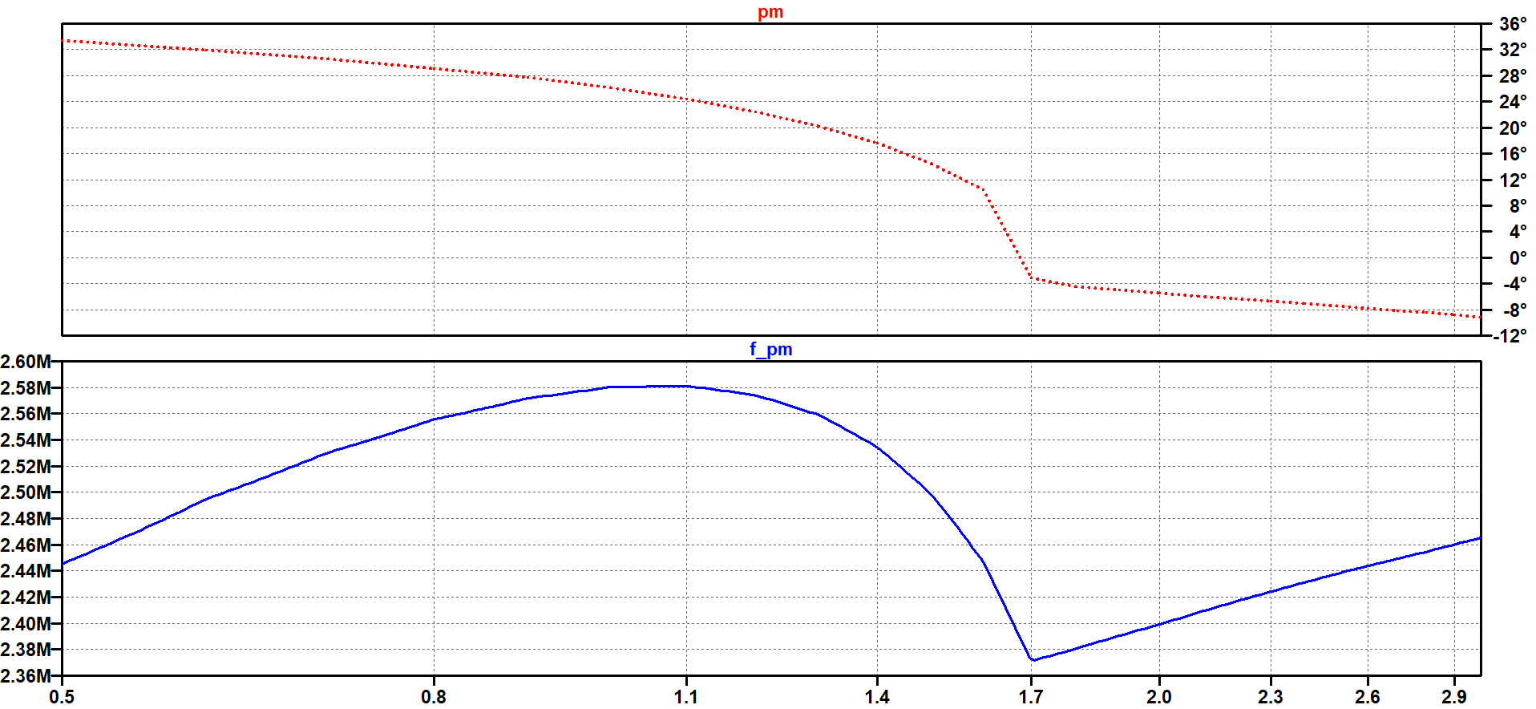
[picture p39: figure]

Figuur 7: Fase marge en bijbehorende frequentie

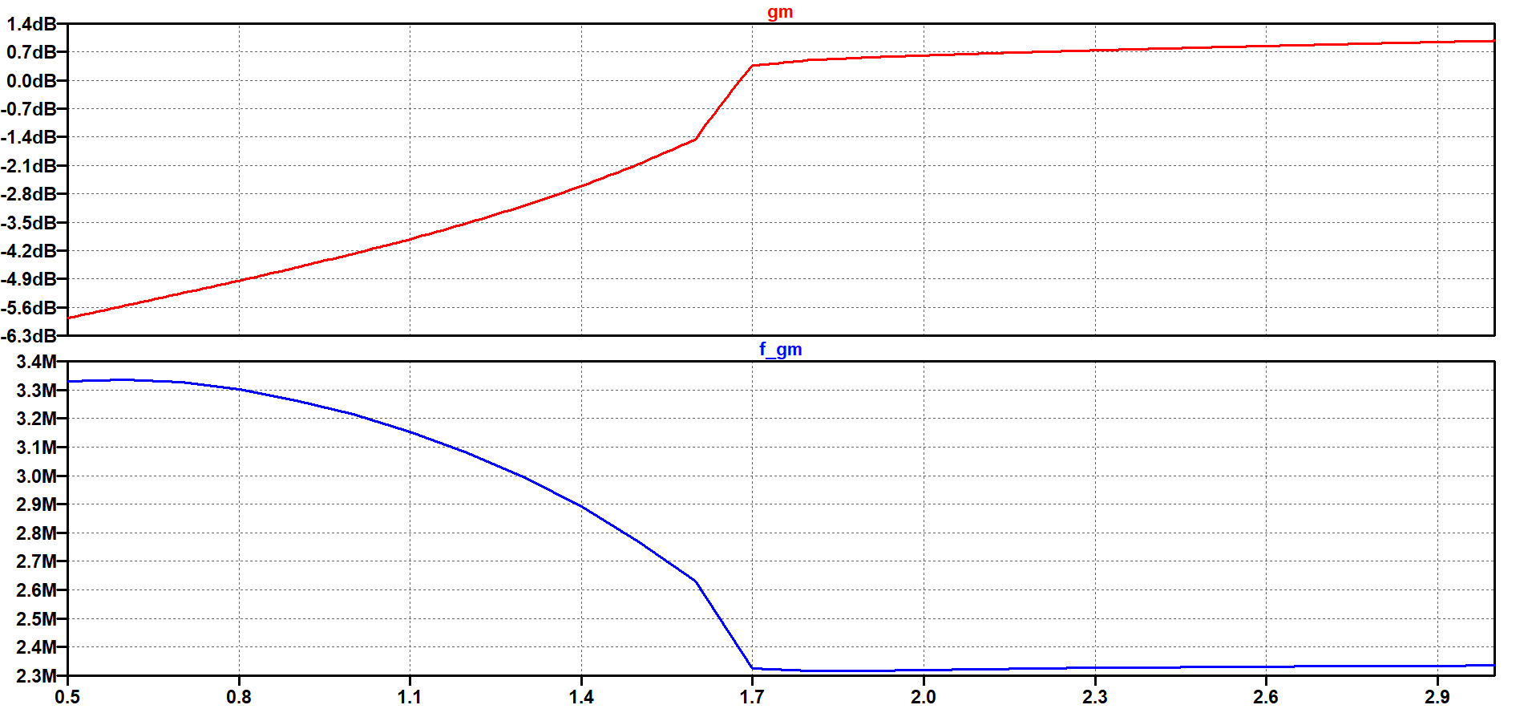
[picture p40: figure]

Figuur 8: Versterkings marge en bijbehorende frequentie
