HeinVerhallen/Hardware_Simulator/Blockdiagrams/Battery_cell_diagram-14_cells.drawio.png

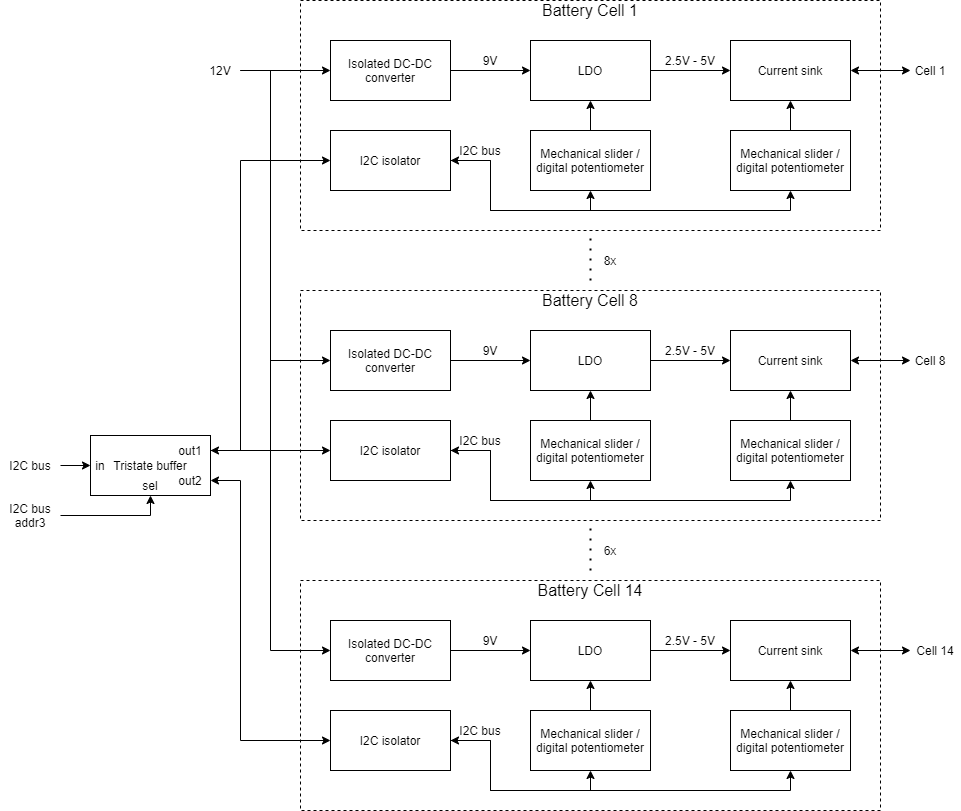
Blockdiagrams/Battery_cell_diagram-14_cells.drawio.png
