HeinVerhallen/Hardware_Simulator/Blockdiagrams/Battery_cell_diagram-Single cell.drawio.png

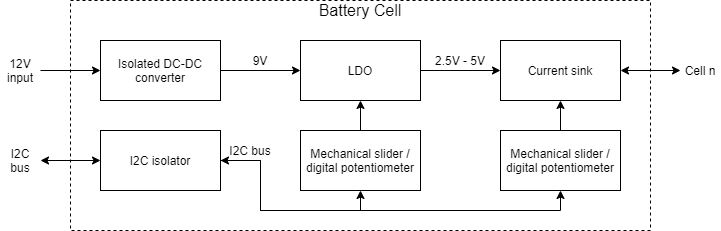
Blockdiagrams/Battery_cell_diagram-Single cell.drawio.png
