HeinVerhallen/Hardware_Simulator/Documentation/Model Design Document/img/Architecture_1st_iteration.png

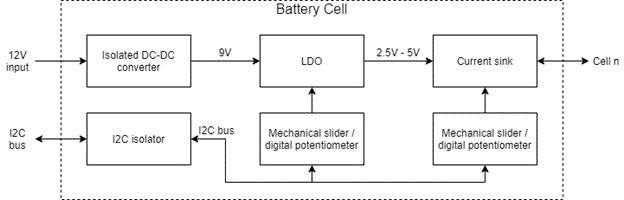
Documentation/Model Design Document/img/Architecture_1st_iteration.png
