HeinVerhallen/Hardware_Simulator/Documentation/Model Design Document/img/ModelBoardTop.jpg

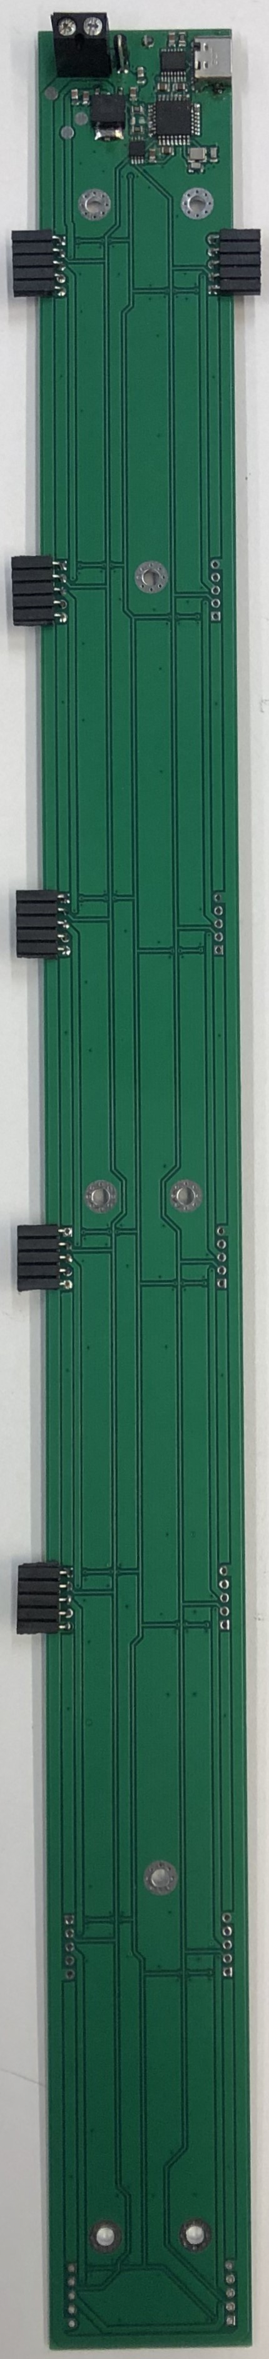
Documentation/Model Design Document/img/ModelBoardTop.jpg
