HeinVerhallen/Hardware_Simulator/Documentation/Model Design Document/Second_Iteration_Testing.tex

\input{Hardware_testing.tex}

\input{Software_testing.tex}
