HeinVerhallen/Hardware_Simulator/Documentation/Model Design Document/img/CurrentSinkPM&GM.pdf

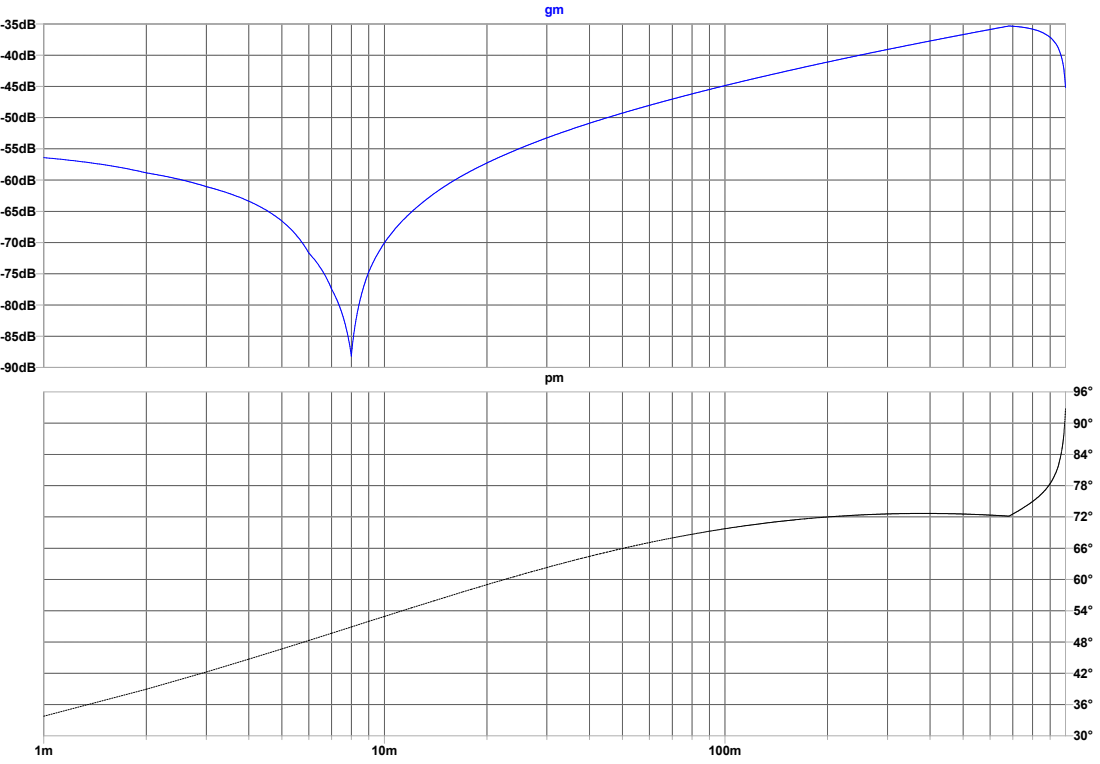
[picture p45: page 1]

--- C:\Users\PC\OneDrive\Documenten\School\Fontys\Project\S7\Hardware_Simulator\Simulations\Current Sink\20231004_Current_sink.log.raw ---
