HeinVerhallen/Hardware_Simulator/Documentation/Model Design Document/img/architecture_2nd_iteration.pdf

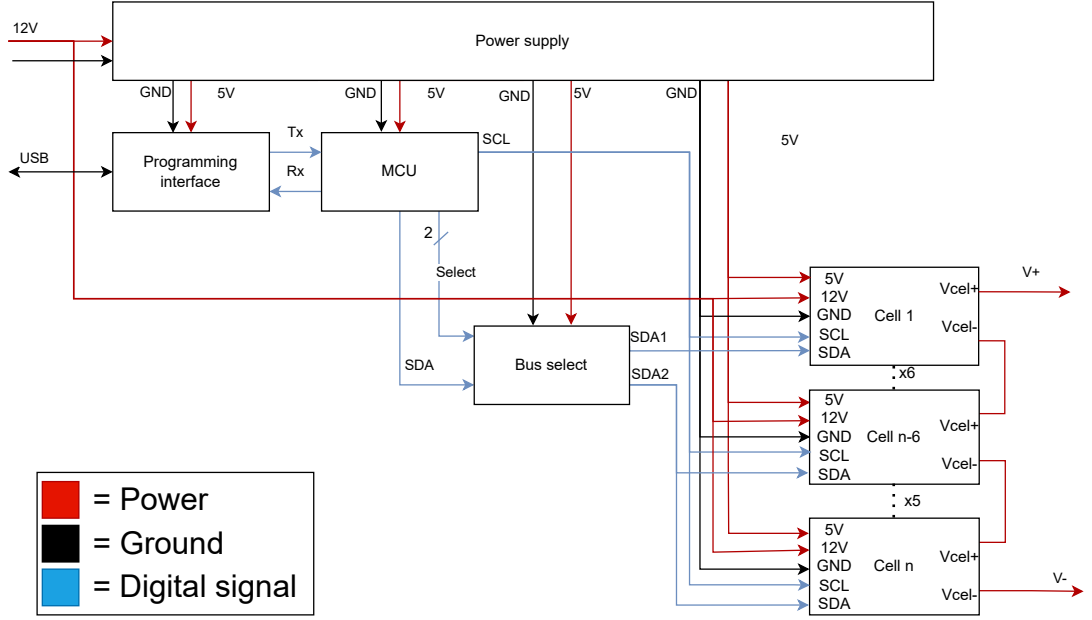
[picture p46: page 1]
Cell 1; Vcel+; Vcel-; 5V 12V GND SCL SDA; GND; Power supply; Cell n-6; Cell n; SCL; SDA; Select; MCU; Programming interface; USB; SDA1; SDA2 Bus select; = Power; = Ground = Digital signal
