HeinVerhallen/Hardware_Simulator/Documentation/Model Design Document/img/architecture_single_cell.pdf

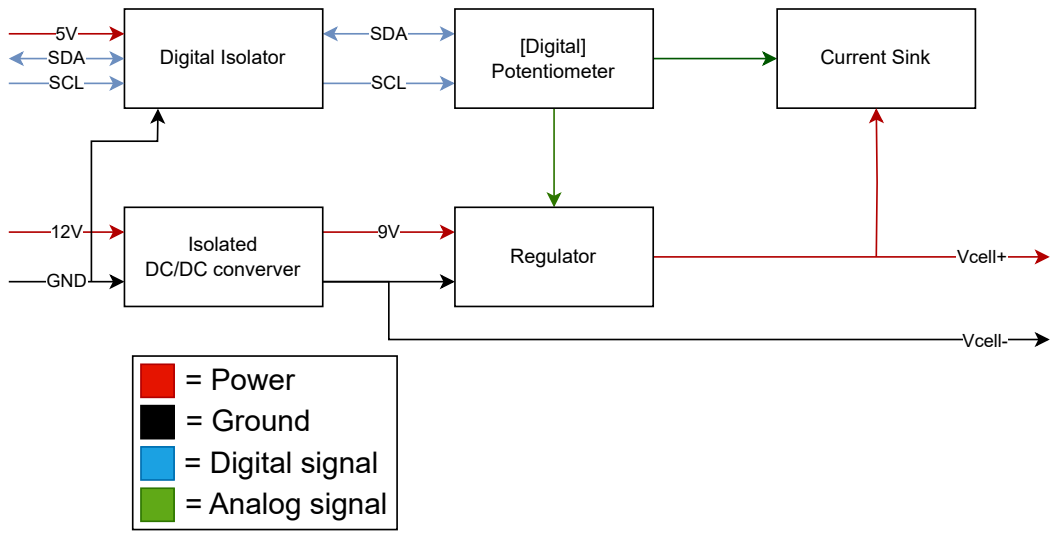
[picture p47: page 1]
SDA; SCL; Digital Isolator; [Digital]; Potentiometer; Current Sink; Vcell-; Isolated; DC/DC converver; Regulator; Vcell+; 5V SDA SCL; GND; = Power = Ground = Digital signal = Analog signal
