HeinVerhallen/Hardware_Simulator/Documentation/Model Design Document/img/Battery_cell_diagram-Single_cell.pdf

## Battery Cell

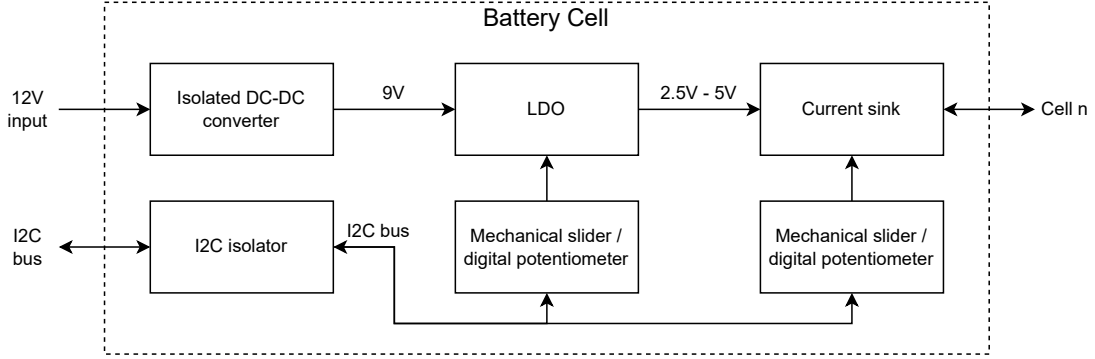
[picture p48: page 1]
converter; LDO; Current sink; Cell n; 12V input; Mechanical slider / digital potentiometer; Mechanical slider /; I2C bus

Isolated DC-DC

digital potentiometer I2C isolator I2C
bus
