HeinVerhallen/Hardware_Simulator/Documentation/Model Design Document/img/LT3080-1_PowerDissipation.pdf

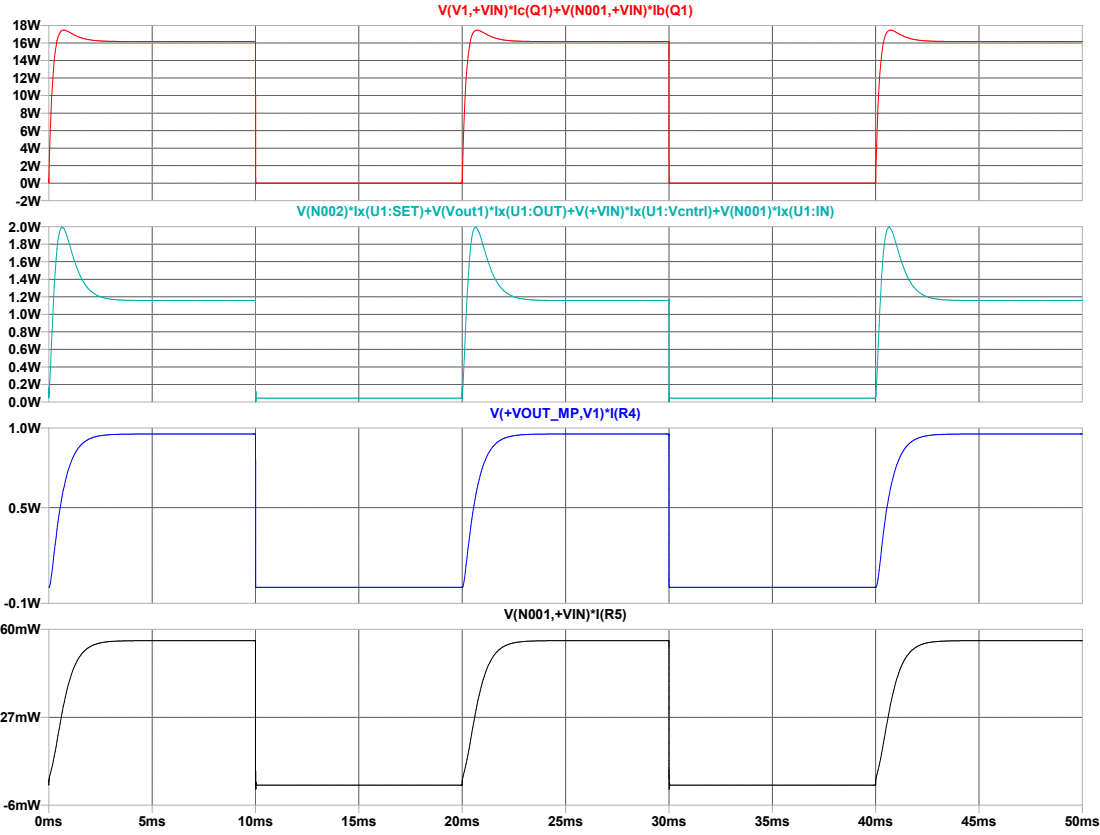
[picture p50: page 1]
V(N001,+VIN)*I(R5); V(+VOUT_MP,V1)*I(R4)

V(V1,+VIN)*Ic(Q1)+V(N001,+VIN)*Ib(Q1)

V(N002)*Ix(U1:SET)+V(Vout1)*Ix(U1:OUT)+V(+VIN)*Ix(U1:Vcntrl)+V(N001)*Ix(U1:IN)

--- C:\Users\robin\OneDrive\Documenten\School\Fontys\Project\S7\Hardware_Simulator\Simulations\Linear-regulator\Period2\LT3080\LT3080.raw ---
