HeinVerhallen/Hardware_Simulator/Documentation/Model Design Document/img/CellBoardKiCADSchematic.pdf

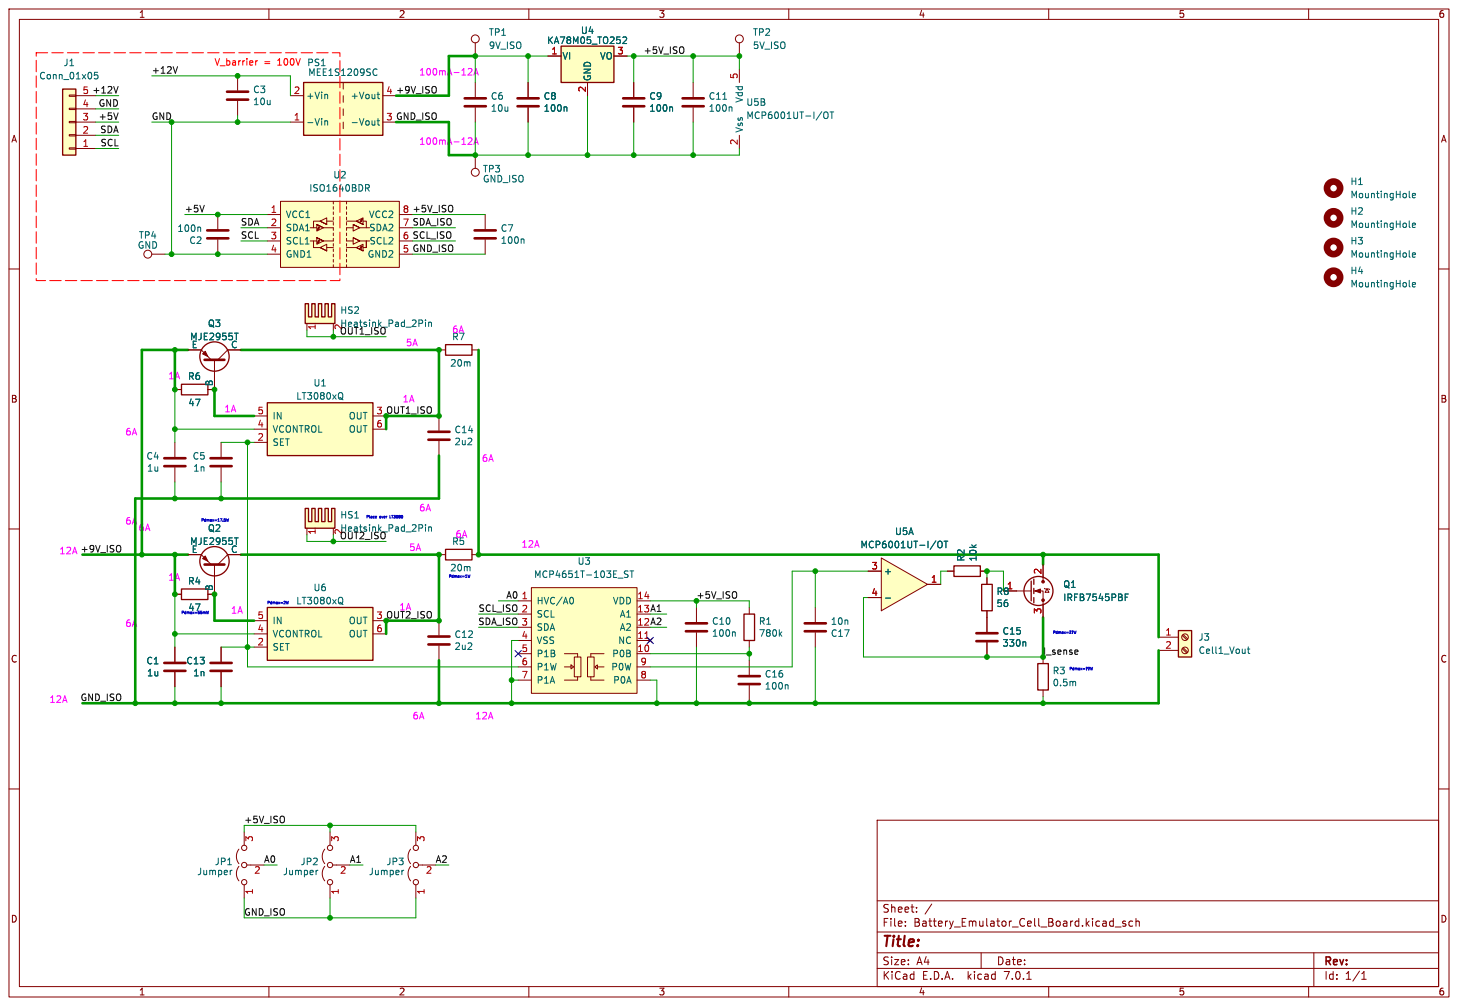
[picture p51: page 1]
