HeinVerhallen/Hardware_Simulator/Documentation/Model Design Document/img/ModelBoardKiCADSchematic.pdf

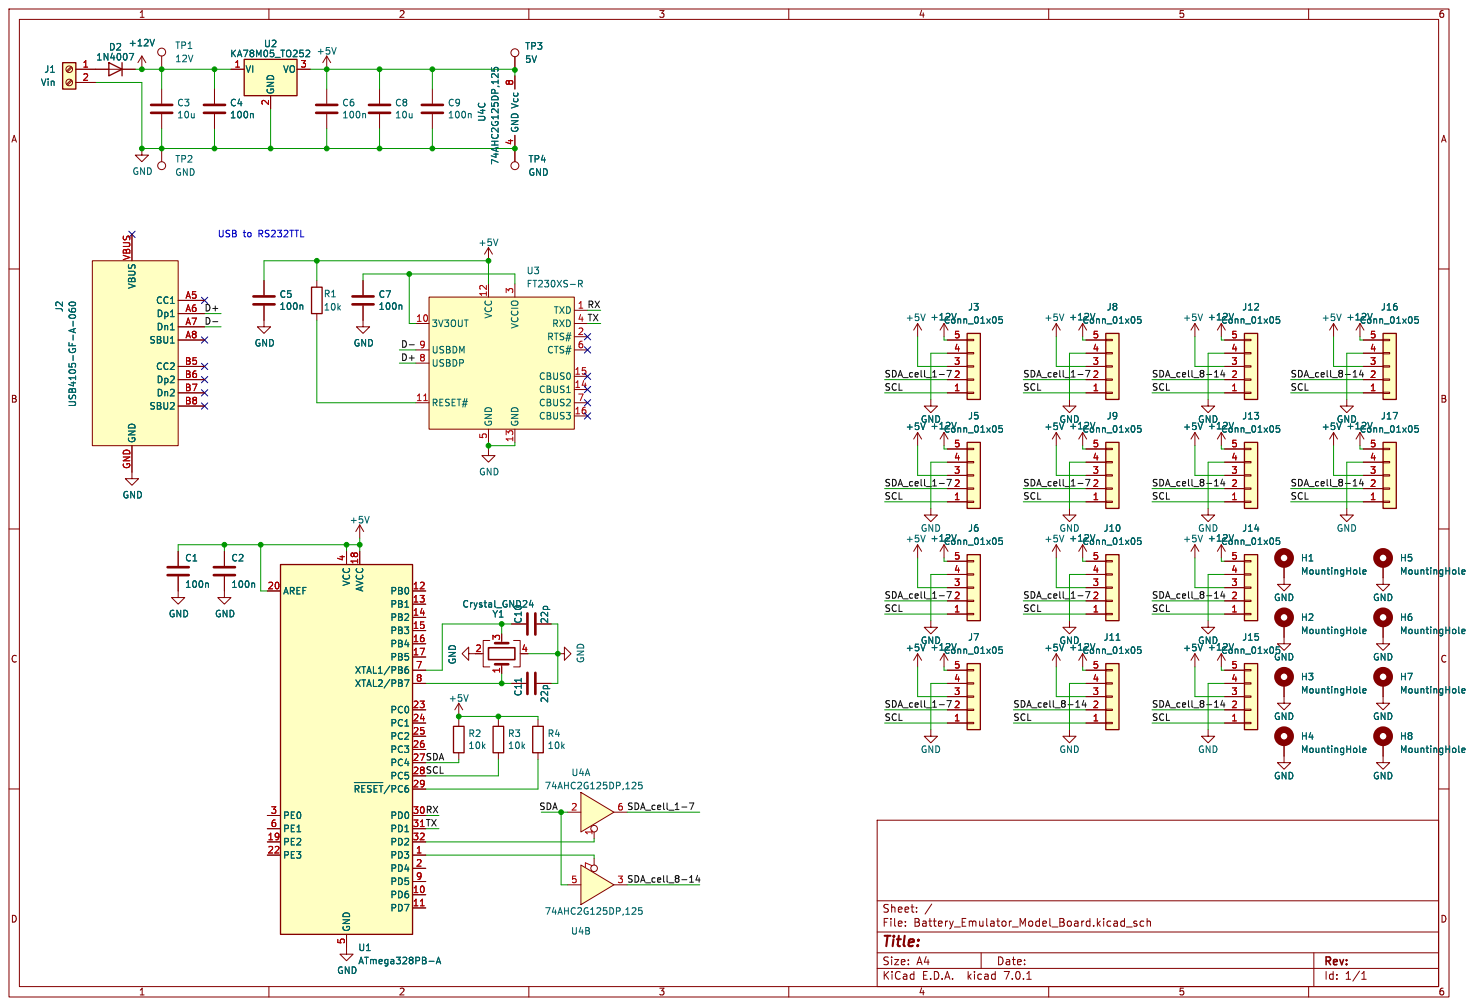
[picture p52: page 1]
