HeinVerhallen/Hardware_Simulator/Documentation/Model Design Document/img/CurrentSinkSchematic.pdf

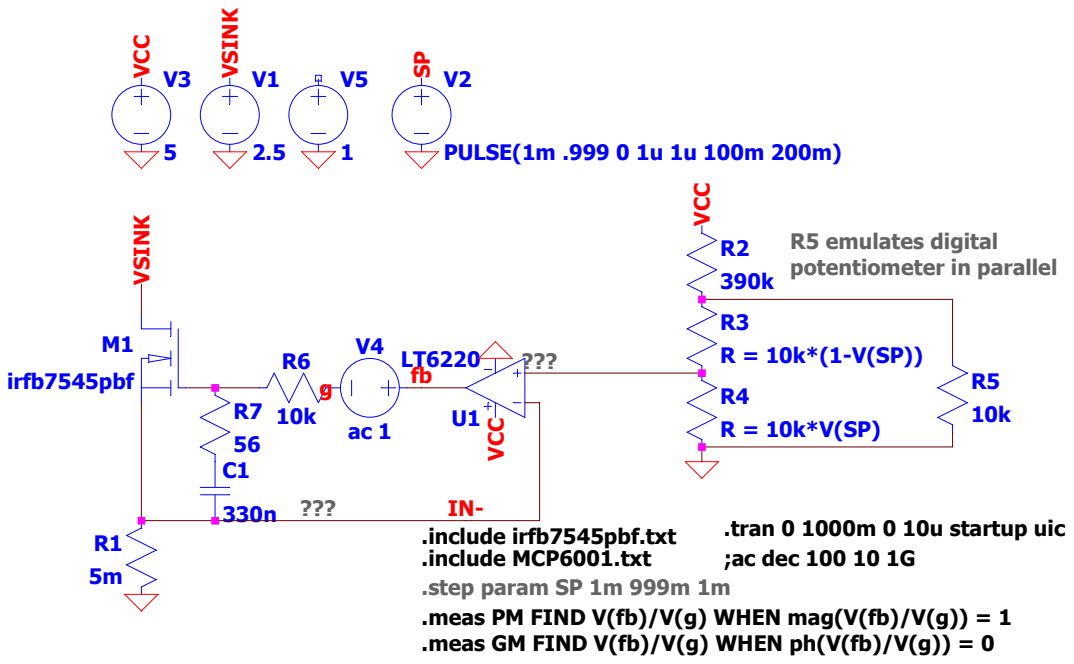
[picture p53: page 1]

.tran 0 1000m 0 10u startup uic .include irfb7545pbf.txt
.step param SP 1m 999m 1m
.meas PM FIND V(fb)/V(g) WHEN mag(V(fb)/V(g)) = 1
.meas GM FIND V(fb)/V(g) WHEN ph(V(fb)/V(g)) = 0
