HeinVerhallen/Hardware_Simulator/Documentation/Model Design Document/img/LT3080-1_LinRegSchematic.pdf

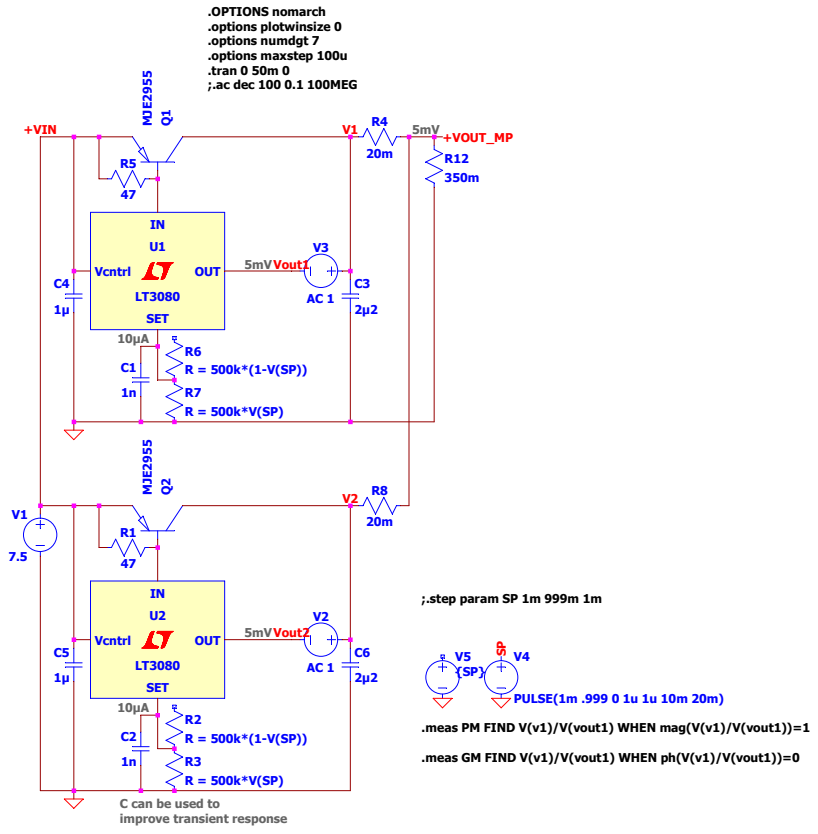
[picture p54: page 1]

.meas PM FIND V(v1)/V(vout1) WHEN mag(V(v1)/V(vout1))=1

.meas GM FIND V(v1)/V(vout1) WHEN ph(V(v1)/V(vout1))=0

C can be used to
improve transient response
