HeinVerhallen/Hardware_Simulator/Simulations/Current Sink/20231004_Current_sink.asc

C1: cap; 330n
M1: nmos; irfb7545pbf
R1: res; 5m
R2: res; 390k
R3: res; R = 10k*(1-V(SP))
R4: res; R = 10k*V(SP)
R5: res; 10k
R6: res; 10k
R7: res; 56
U1: LT6220
V1: voltage; 2.5
V2: voltage; PULSE(1m .999 0 1u 1u 100m 200m)
V3: voltage; 5
V4: voltage; ac 1
V5: voltage; {SP}
Named nets: 0, VSINK, VCC, SP, IN-, fb, g
.tran 0 1000m 0 10u startup uic
.include irfb7545pbf.txt
.include MCP6001.txt
R5 emulates digital
potentiometer in parallel
.ac dec 100 10 1G
.step param SP 1m 999m 1m
.meas PM FIND V(fb)/V(g) WHEN mag(V(fb)/V(g)) = 1
.meas GM FIND V(fb)/V(g) WHEN ph(V(fb)/V(g)) = 0
