HeinVerhallen/Hardware_Simulator/Simulations/Current Sink/20231004_Current_sink_discrete.asc

M1: nmos; irfb7545pbf
Q1: npn; BC847A
Q2: npn; BC847A
Q3: pnp; BC857A
Q4: pnp; BC857A
Q5: npn; BC847A
Q6: npn; BC847A
R1: res; 5m
R2: res; 390k
R3: res; R = 10k*(1-V(SP))
R4: res; R = 10k*V(SP)
R5: res; 10k
R6: res; {Rg}
R7: res; 1k8
R9: res; 33
R10: res; 33
R11: res; 2k2
R12: res; 2k2
R13: res; 2k2
R14: res; 2k2
V1: voltage; 2.5
V2: voltage; PULSE(1m .999 0 1u 1u 10m 20m)
V3: voltage; 5
V4: voltage; ac 1
V5: voltage; 999m
V6: voltage; 9
V7: voltage; 2
V8: voltage; 2
Named nets: 0, VSINK, +9V, SP, +5V, IN-, IN+, OUT
.tran 0 100m 0 10u startup uic
.include irfb7545pbf.txt
R5 emulates digital
potentiometer in parallel
.ac dec 100 10k 10MEG
.step param Rg list 1k 4k7 10k
.op
Voltage shifters
