HeinVerhallen/Hardware_Simulator/Simulations/DC-load/DC_Motor.asc

H1: h; Va {KT}
Hvb: h; Vw {Kb}
Hvw: h; Vw 1
La: ind; {La * Second_Order + 1p}; Rser=1n
Ljm: ind; {Jm}; Rser=1n
Ra: res; {Ra}
Rdm: res; {Dm + Block_Motor*1G}
Va: voltage; 0
Vw: voltage; 0
Named nets: b, T, w, Ea, W, GND
.params
+ Ra = 1.2;
+ La = 0.02;
+ Kb = 0.06;
+ Jm = 6.2E-4;
+ Dm = 1E-4;
+ KT = 0.06;
.tran 0 1 0
