HeinVerhallen/Hardware_Simulator/Simulations/DC-load/DC-load.asc

A: bv; V=(I(I_sense2))*K_EMF
B: bv; V=(I(I_sense1))*K_t
Back_EMF: h; A; 1
H1: h; SP_M; 1
I_sense1: voltage; 0
I_sense2: voltage; 0
L_inertia: ind; {L_inertia}
L_motor: ind; {L_motor}
M1: nmos; IRFZ44N
M2: nmos; IRFZ44N
M3: nmos; IRFZ44N
M4: nmos; IRFZ44N
M5: nmos; IRFZ44N
R1: res; 100m
R2: res; 400m
R3: res; 10
R4: res; 400m
R5: res; 10
R6: res; 400m
R7: res; 10
R8: res; 400m
R9: res; 10
R_loss: res; {R_loss}
R_motor: res; {R_motor}
SP_M: voltage; 0
U1: NE5532
U2: NE5532
V2: voltage; 80
V3: voltage; 12
V4: voltage; SINE(80m 80m 1k)
V_torque: h; B; 1
Vmotor: voltage; PULSE(0 1 0 1n 1n 1)
Named nets: 0, VBMS, +12V, SP, VLOAD
.tran 0 2m 0
Basic principle
Load sharing to spread dissipation
Basic DC-motor load simulation
to give MCU analog output
as SP.
SP, choose one option:
Sine wave
.PARAM K_t = 900u
.PARAM K_EMF = 900u
.PARAM L_motor = 50u
.PARAM R_motor = 5.5
.PARAM R_loss = 300n
.PARAM L_inertia = 15n
https://www.precisionmicrodrives.com/ab-025
Used for multiplication since current controlled voltage sources do not support this
Supplies and sim command
Operating principle of a DC-load
