HeinVerhallen/Hardware_Simulator/Simulations/Linear-regulator/Period1/PMOS_lin_reg - V4_ESR.asc

C1: cap; 1n
C11: cap; 100µ; Rser=10m
M1: pmos; irfp9140n
R1: res; 1
R2: res; 1k
R3: res; 100
R4: res; 0.1
R10: res; 100k
R11: res; 100k
R12: res; 10
U4: LT6220
V1: voltage; 7.5
V2: voltage; {Vsp}
V3: voltage; 0; AC 1
Named nets: +VIN, 0, SP, +VOUT_MP, G, Vfb, inp
.OPTIONS nomarch
.options plotwinsize 0
.options numdgt 7
.options maxstep 100u
; .tran 0 200m 0
.ac dec 100 0.1 100MEG
.include irfp9140n.txt
https://nl.mouser.com/ProductDetail/Infineon-Technologies/IRFP9140NPBF?qs=9%252BKlkBgLFf2vr%2FSYvxJmQw%3D%3D
.meas f_PM WHEN mag(V(vfb)/V(g))=1
.meas PM FIND V(vfb)/V(g) WHEN mag(V(vfb)/V(g))=1
 
.meas f_GM WHEN ph(V(vfb)/V(g))=0
.meas GM FIND V(vfb)/V(g) WHEN ph(V(vfb)/V(g))=0
.param Vsp=3
.step param Vsp 0.5 3 0.1
