HeinVerhallen/Hardware_Simulator/Simulations/Linear-regulator/Period2/PMOS_lin_reg - irf9140n_V3.asc

C1: cap; 1n
C2: cap; 1n
C3: cap; 1n; Rser=10m
C11: cap; 100µ; Rser=10m
M1: pmos; irfp9140n
R1: res; 330
R2: res; 2200
R3: res; 220
R10: res; 10k
R11: res; 10k
R12: res; 0.5
R13: res; 10k
U1: LT6220
V1: voltage; 7.5
V2: voltage; {Vsp}
V3: voltage; 0; AC 1
Named nets: +VIN, SP, +VOUT_MP, G, Vfb, inp, 0
.OPTIONS nomarch
.options plotwinsize 0
.options numdgt 7
.options maxstep 100u
;.tran 0 200m 0
.ac dec 100 0.1 100MEG
.lib irfp9140n.lib
.meas f_PM WHEN mag(V(vfb)/V(g))=1
.meas PM FIND V(vfb)/V(g) WHEN mag(V(vfb)/V(g))=1
 
.meas f_GM WHEN ph(V(vfb)/V(g))=0
.meas GM FIND V(vfb)/V(g) WHEN ph(V(vfb)/V(g))=0
.param Vsp=3
.step param Vsp 0.5 3 0.5
