HeinVerhallen/Hardware_Simulator/Simulations/Linear-regulator/Period1/Linear-regulator.asc

C1: cap; 100n
C2: cap; 100n
C3: cap; 1n
C4: cap; 100µ; Rser=10m
C6: cap; 100µ; Rser=10m
C15: cap; 1n
M1: nmos; IRFZ44N
Q1: npn; 2N3055
Q2: npn; 2N2222
R1: res; 10
R2: res; 10k
R3: res; 10k
R4: res; 10k
R5: res; 10k
R6: res; 400m
U1: LT6220
U2: LT6220
V1: voltage; 7.5
V2: voltage; PULSE(0 5.5 0 100m 100m 0)
V3: voltage; ""; AC 1
V5: voltage; ""; AC 1
Named nets: 0, +VIN, +VOUT_M, S, SP, G, +VOUT_T, E, B
.OPTIONS nomarch
.options plotwinsize 0
.options numdgt 7
.options maxstep 100u
.tran 0 200m 0
.ac dec 100 100 100MEG
Further analize and optimize design (dropout)
