HeinVerhallen/Hardware_Simulator/Simulations/Linear-regulator/Period2/LT3080/LT3080.asc

C1: cap; 1n
C2: cap; 1n
C3: cap; 2µ2
C4: cap; 1µ
C5: cap; 1µ
C6: cap; 2µ2
Q1: pnp; MJE2955
Q2: pnp; MJE2955
R1: res; 47
R2: res; R = 500k*(1-V(SP))
R3: res; R = 500k*V(SP)
R4: res; 20m
R5: res; 47
R6: res; R = 500k*(1-V(SP))
R7: res; R = 500k*V(SP)
R8: res; 20m
R12: res; 350m
U1: LT3080
U2: LT3080
V1: voltage; 7.5
V2: voltage; 0; AC 1
V3: voltage; 0; AC 1
V4: voltage; PULSE(1m .999 0 1u 1u 10m 20m)
V5: voltage; {SP}
Named nets: +VIN, Vout1, 0, +VOUT_MP, Vout2, SP, V1, V2
.OPTIONS nomarch
.options plotwinsize 0
.options numdgt 7
.options maxstep 100u
;.tran 0 50m 0
.ac dec 100 0.1 100MEG
.meas PM FIND V(v1)/V(vout1) WHEN mag(V(v1)/V(vout1))=1
 
.meas GM FIND V(v1)/V(vout1) WHEN ph(V(v1)/V(vout1))=0
10µA
C can be used to
improve transient response
10µA
.step param SP 1m 999m 10m
