HeinVerhallen/Hardware_Simulator/Hardware/Battery_Emulator_v3/Battery_Emulator_Model_Board/Battery_Emulator_Model_Board.kicad_pcb

## KiCad design Hardware/Battery_Emulator_v3/Battery_Emulator_Model_Board/Battery_Emulator_Model_Board.kicad_pcb (2023-12-06)

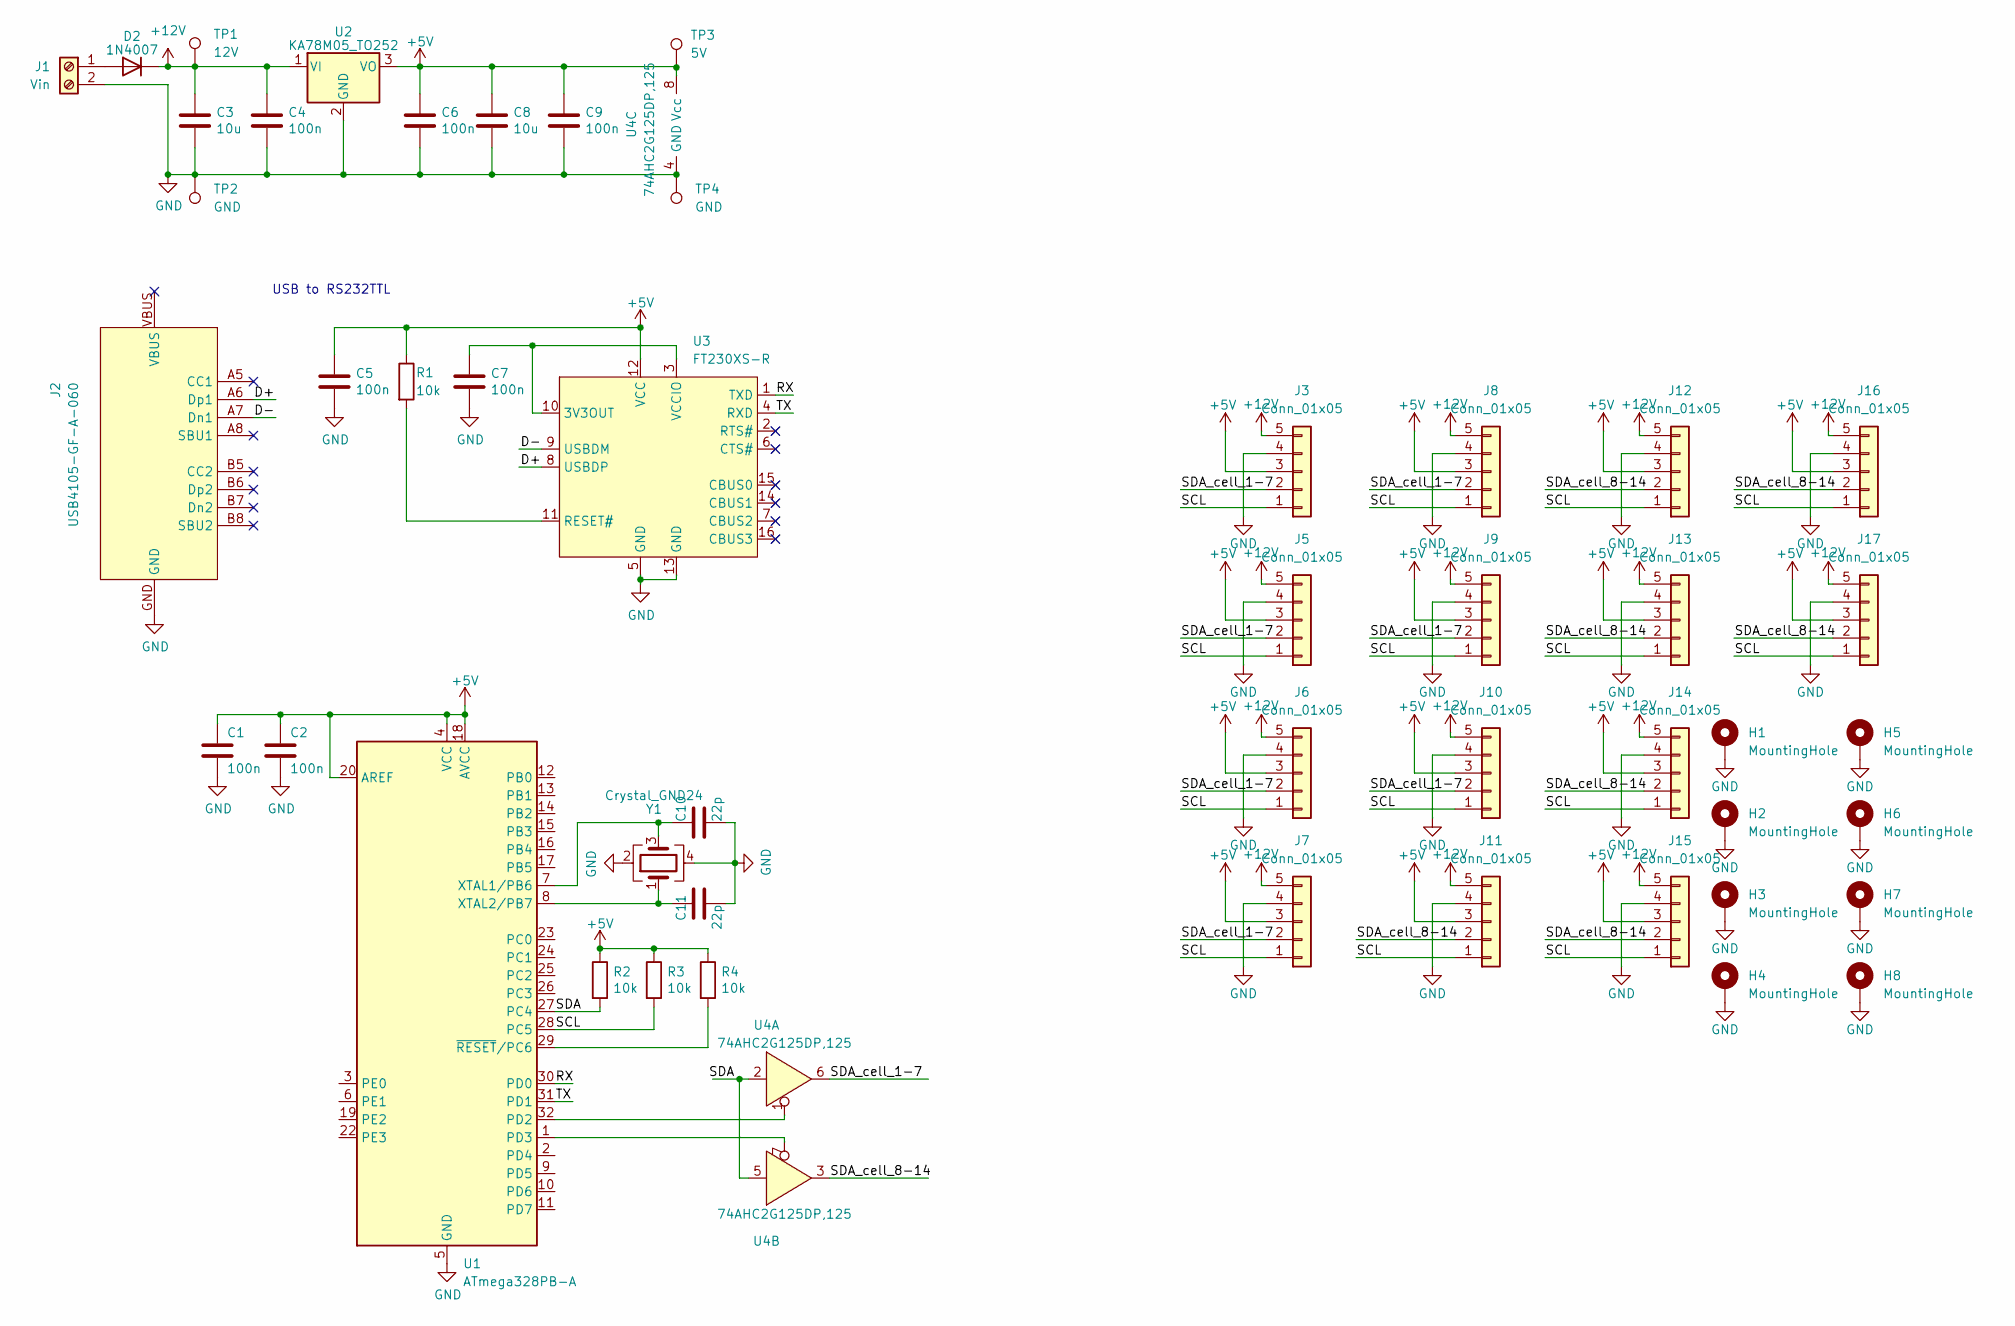
[picture p55: schematic Battery_Emulator_Model_Board.kicad_sch]

Parts:
C1, C2, C4, C5, C6, C7, C9: 100n; C_0805_2012Metric
C3, C8: 10u; C_0805_2012Metric
C10, C11: 22p; C_0805_2012Metric
D2: 1N4007; D_DO-41_SOD81_P2.54mm_Vertical_KathodeUp
H1, H2, H3, H4, H5, H6, H7, H8: MountingHole; MountingHole_3.2mm_M3_Pad_Via
J1: Vin; TerminalBlock_Phoenix_MKDS-1,5-2-5.08_1x02_P5.08mm_Horizont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
J2: USB4105-GF-A-060; GCT_USB4105-GF-A-060
J3, J5, J6, J7, J8, J9, J10, J11, J12, J13, J14, J15, J16, J17: Conn_01x05; PinSocket_1x05_P2.54mm_Horizontal
R1, R2, R3, R4: 10k; R_0805_2012Metric
TP1: 12V; TestPoint_Pad_D2.5mm
TP2, TP4: GND; TestPoint_Pad_D2.5mm
TP3: 5V; TestPoint_Pad_D2.5mm
U1: ATmega328PB-A; TQFP-32_7x7mm_P0.8mm
U2: KA78M05_TO252; TO-252-2
U3: FT230XS-R; SSOP-16_3.9x4.9mm_P0.635mm
U4: 74AHC2G125DP,125; TSSOP-8_3x3mm_P0.65mm
Y1: Crystal_GND24; Crystal_SMD_3225-4Pin_3.2x2.5mm

Connections:
+5V: C1.1, C2.1, C5.1, C6.1, C8.1, C9.1, J3.3, J5.3, J6.3, J7.3, J8.3, J9.3, J10.3, J11.3, J12.3, J13.3, J14.3, J15.3, J16.3, J17.3, R1.1, R2.1, R3.1, R4.1, TP3.1, U1.4 (VCC), U1.18 (AVCC), U1.20 (AREF), U2.3 (VO), U3.12 (VCC), U4.8 (Vcc)
+12V: C3.1, C4.1, D2.1 (K), J3.5, J5.5, J6.5, J7.5, J8.5, J9.5, J10.5, J11.5, J12.5, J13.5, J14.5, J15.5, J16.5, J17.5, TP1.1, U2.1 (VI)
/D+: J2.A6 (Dp1), U3.8 (USBDP)
/D-: J2.A7 (Dn1), U3.9 (USBDM)
/RX: U1.30 (PD0), U3.1 (TXD)
/SCL: J3.1, J5.1, J6.1, J7.1, J8.1, J9.1, J10.1, J11.1, J12.1, J13.1, J14.1, J15.1, J16.1, J17.1, R3.2, U1.28 (PC5)
/SDA: R2.2, U1.27 (PC4), U4.2, U4.5
/SDA_cell_1-7: J3.2, J5.2, J6.2, J7.2, J8.2, J9.2, J10.2, U4.6
/SDA_cell_8-14: J11.2, J12.2, J13.2, J14.2, J15.2, J16.2, J17.2, U4.3
/TX: U1.31 (PD1), U3.4 (RXD)
GND: C1.2, C2.2, C3.2, C4.2, C5.2, C6.2, C7.2, C8.2, C9.2, C10.2, C11.2, H1.1, H2.1, H3.1, H4.1, H5.1, H6.1, H7.1, H8.1, J1.2, J2.GND, J3.4, J5.4, J6.4, J7.4, J8.4, J9.4, J10.4, J11.4, J12.4, J13.4, J14.4, J15.4, J16.4, J17.4, TP2.1, TP4.1, U1.5 (GND), U1.21 (GND), U2.2 (GND), U3.5 (GND), U3.13 (GND), U4.4 (GND), Y1.2, Y1.4
unnamed: D2.2 (A), J1.1
unnamed: U1.32 (PD2), U4.1
unnamed: U1.1 (PD3), U4.7
unnamed: C10.1, U1.7 (XTAL1/PB6), Y1.3
unnamed: C11.1, U1.8 (XTAL2/PB7), Y1.1
unnamed: R4.2, U1.29 (~RESET/PC6)
unnamed: C7.1, U3.3 (VCCIO), U3.10 (3V3OUT)
unnamed: R1.2, U3.11 (RESET#)

Notes on the sheet:
USB to RS232TTL

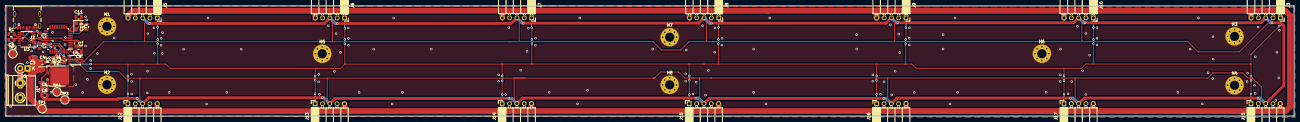
[picture p56: board Battery_Emulator_Model_Board.kicad_pcb from above]

Board: 2 copper layers, 446.7 x 38.2 mm, 49 parts (0 on the bottom side), 19 nets.
