HeinVerhallen/Hardware_Simulator/Hardware/Battery_Emulator_v3/Battery_Emulator_Cell_Board/Battery_Emulator_Cell_Board.kicad_pcb

## KiCad design Hardware/Battery_Emulator_v3/Battery_Emulator_Cell_Board/Battery_Emulator_Cell_Board.kicad_pcb (2023-12-06)

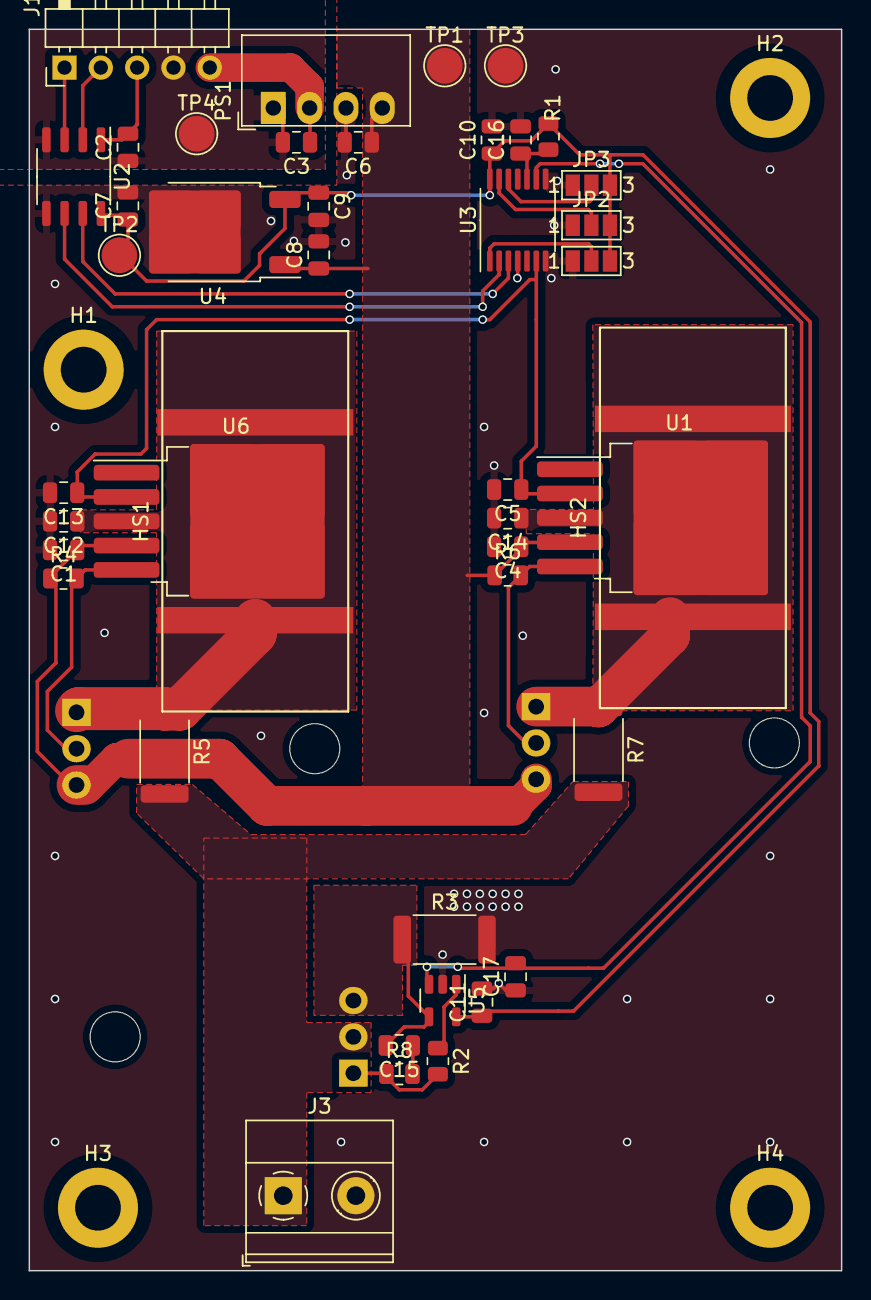
[picture p57: board Battery_Emulator_Cell_Board.kicad_pcb from above]

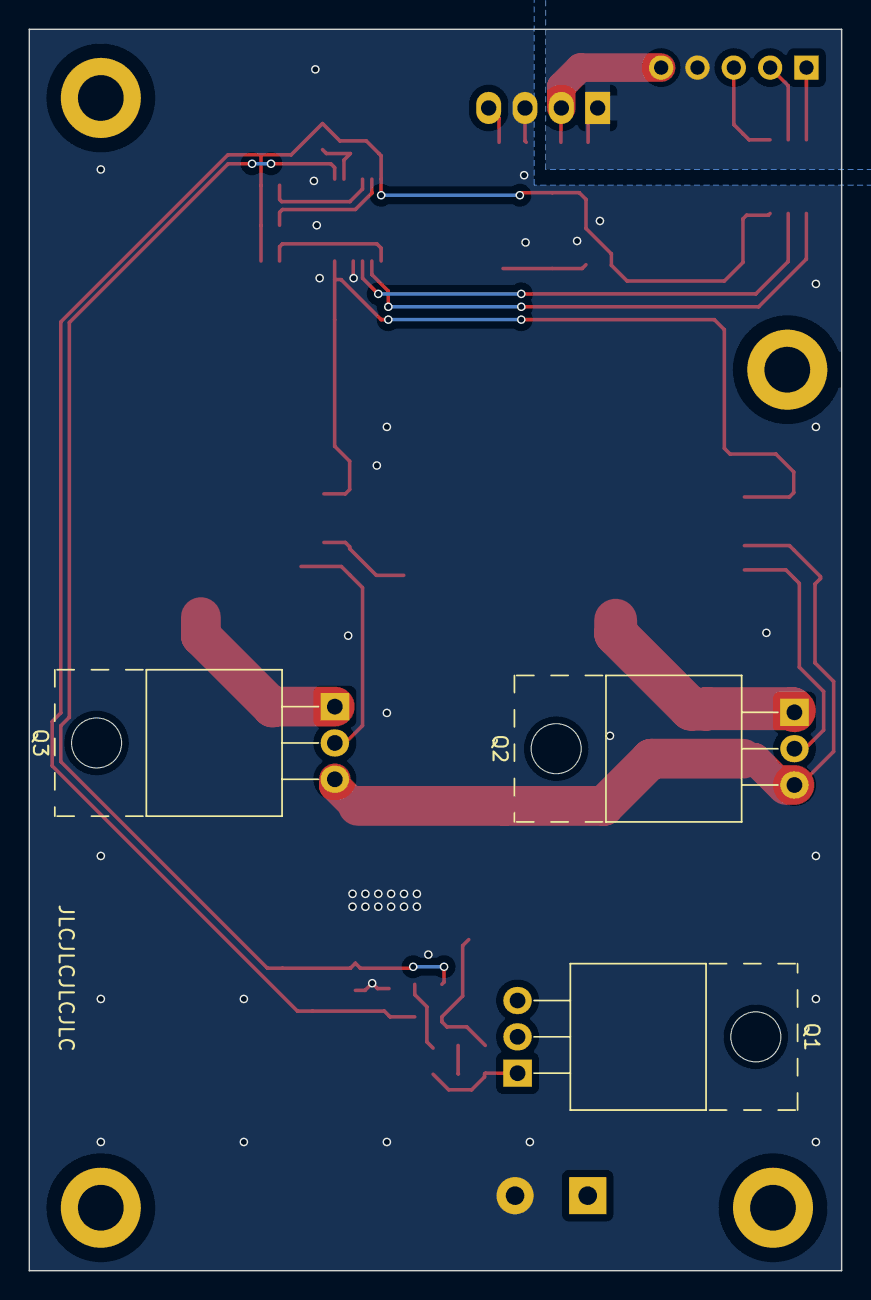
[picture p58: board Battery_Emulator_Cell_Board.kicad_pcb from below]

Board: 2 copper layers, 56.8 x 86.8 mm, 50 parts (3 on the bottom side), 25 nets.

Parts:
C1, C4: 1u; C_0805_2012Metric
C2, C7, C8, C9, C10, C11, C16: 100n; C_0805_2012Metric
C3, C6: 10u; C_0805_2012Metric
C5, C13: 1n; C_0805_2012Metric
C12, C14: 2u2; C_0805_2012Metric
C15: 330n; C_0805_2012Metric
C17: 10n; C_0805_2012Metric
H1, H2, H3, H4: MountingHole; MountingHole_3.2mm_M3_DIN965_Pad
HS1, HS2: Heatsink_Pad_2Pin; Heatsink_AAVID_573300D00010G_TO-263
J1: Conn_01x05; PinHeader_1x05_P2.54mm_Horizontal
J3: Cell1_Vout; TerminalBlock_Phoenix_MKDS-1,5-2-5.08_1x02_P5.08mm_Horizont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
JP1, JP2, JP3: Jumper; SolderJumper-3_P1.3mm_Open_Pad1.0x1.5mm_NumberLabels
PS1: MEE1S1209SC; Converter_DCDC_Murata_MEE1SxxxxSC_THT
Q1: IRFB7545PBF; TO-220-3_Horizontal_TabUp
Q2, Q3: MJE2955T; TO-220-3_Horizontal_TabUp
R1: 780k; R_0805_2012Metric
R2: 10k; R_0805_2012Metric
R3: 0.5m; R_2512_6332Metric
R4, R6: 47; R_0805_2012Metric
R5, R7: 20m; R_2512_6332Metric
R8: 56; R_0805_2012Metric
TP1: 9V_ISO; TestPoint_Pad_D2.5mm
TP2: 5V_ISO; TestPoint_Pad_D2.5mm
TP3: GND_ISO; TestPoint_Pad_D2.5mm
TP4: GND; TestPoint_Pad_D2.5mm
U1, U6: LT3080xQ; TO-263-5_TabPin3
U2: ISO1640BDR; SO-8_3.9x4.9mm_P1.27mm
U3: MCP4651T-103E_ST; TSSOP-14_4.4x5mm_P0.65mm
U4: KA78M05_TO252; TO-252-2
U5: MCP6001UT-I/OT; SOT-23-5

Connections:
/+5V: C2.2, J1.3, U2.1 (VCC1)
/+5V_ISO: C7.1, C9.1, C10.1, C11.1, JP1.3 (B), JP2.3 (B), JP3.3 (B), R1.1, TP2.1, U2.8 (VCC2), U3.14 (VDD), U4.3 (VO), U5.5 (Vdd)
/+9V_ISO: C1.1, C4.1, C6.1, C8.1, PS1.4 (+Vout), Q2.3 (E), Q3.3 (E), R4.1, R6.1, TP1.1, U1.4 (VCONTROL), U4.1 (VI), U6.4 (VCONTROL)
/+12V: C3.1, J1.5, PS1.2 (+Vin)
/A0: JP1.2 (C), U3.1 (HVC/A0)
/A1: JP2.2 (C), U3.13 (A1)
/A2: JP3.2 (C), U3.12 (A2)
/GND: C2.1, C3.2, J1.4, PS1.1 (-Vin), TP4.1, U2.4 (GND1)
/GND_ISO: C1.2, C4.2, C5.2, C6.2, C7.2, C8.2, C9.2, C10.2, C11.2, C12.2, C13.2, C14.2, C16.2, C17.1, J3.2, JP1.1 (A), JP2.1 (A), JP3.1 (A), PS1.3 (-Vout), R3.2, TP3.1, U2.5 (GND2), U3.4 (VSS), U3.7 (P1A), U3.8 (P0A), U4.2 (GND), U5.2 (Vss)
/I_sense: C15.2, Q1.3, R3.1, U5.4 (-)
/OUT1_ISO: C14.1, HS2.1, Q3.1 (C), R7.1, U1.3 (OUT)
/OUT2_ISO: C12.1, HS1.1, Q2.1 (C), R5.1, U6.3 (OUT)
/SCL: J1.1, U2.3 (SCL1)
/SCL_ISO: U2.6 (SCL2), U3.2 (SCL)
/SDA: J1.2, U2.2 (SDA1)
/SDA_ISO: U2.7 (SDA2), U3.3 (SDA)
unnamed: C15.1, R8.2
unnamed: J3.1, Q1.2, R5.2, R7.2
unnamed: Q1.1, R2.2, R8.1
unnamed: Q2.2 (B), R4.2, U6.5 (IN)
unnamed: Q3.2 (B), R6.2, U1.5 (IN)
unnamed: R2.1, U5.1
unnamed: C5.1, C13.1, U1.2 (SET), U3.6 (P1W), U6.2 (SET)
unnamed: C16.1, R1.2, U3.10 (P0B)
unnamed: C17.2, U3.9 (P0W), U5.3 (+)
