HeinVerhallen/Hardware_Simulator/Hardware/Battery_Emulator_v2/Battery_Emulator.kicad_pcb

## KiCad design Hardware/Battery_Emulator_v2/Battery_Emulator.kicad_pcb (2023-11-15, an earlier design)

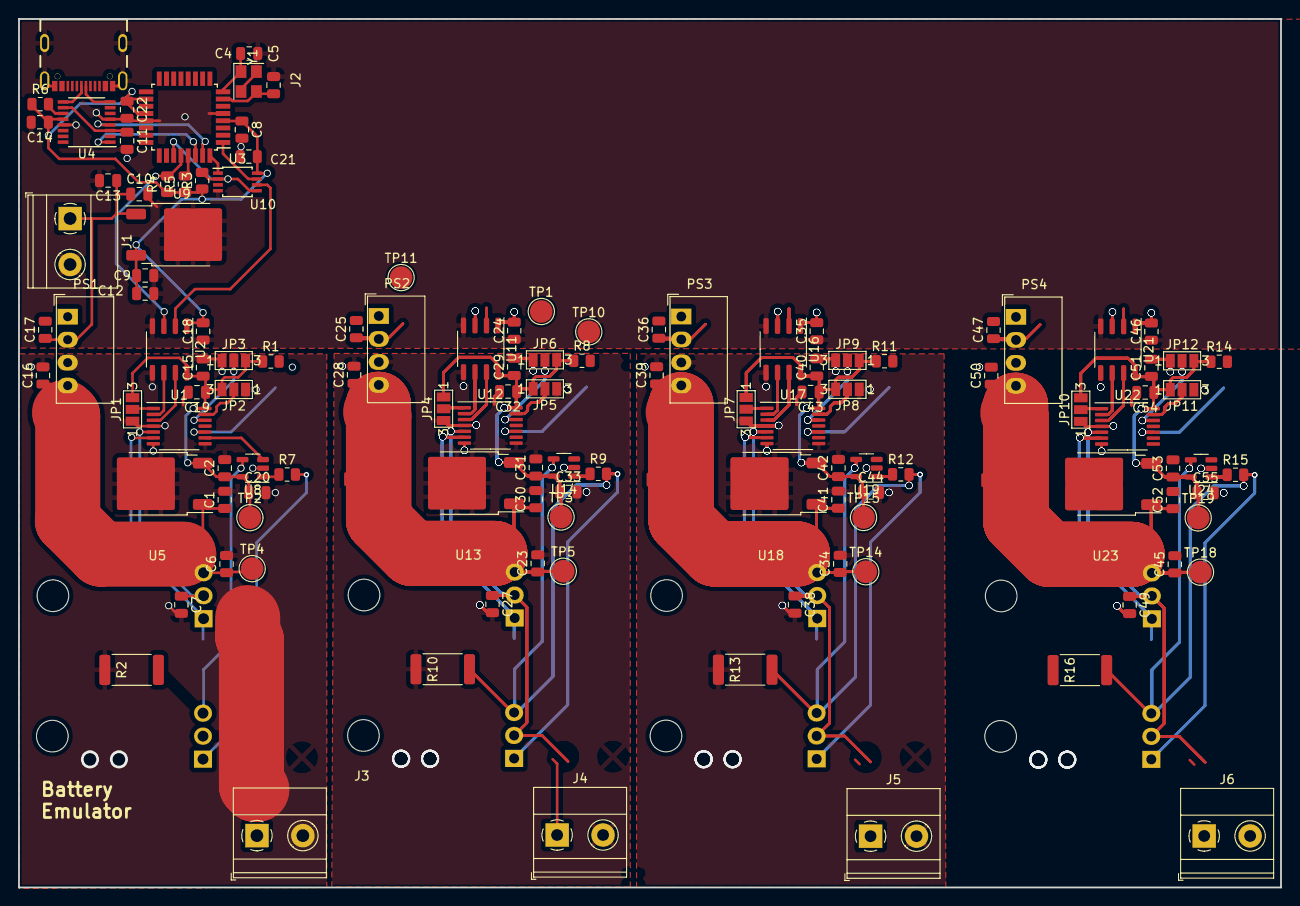
[picture p59: board Battery_Emulator.kicad_pcb from above]

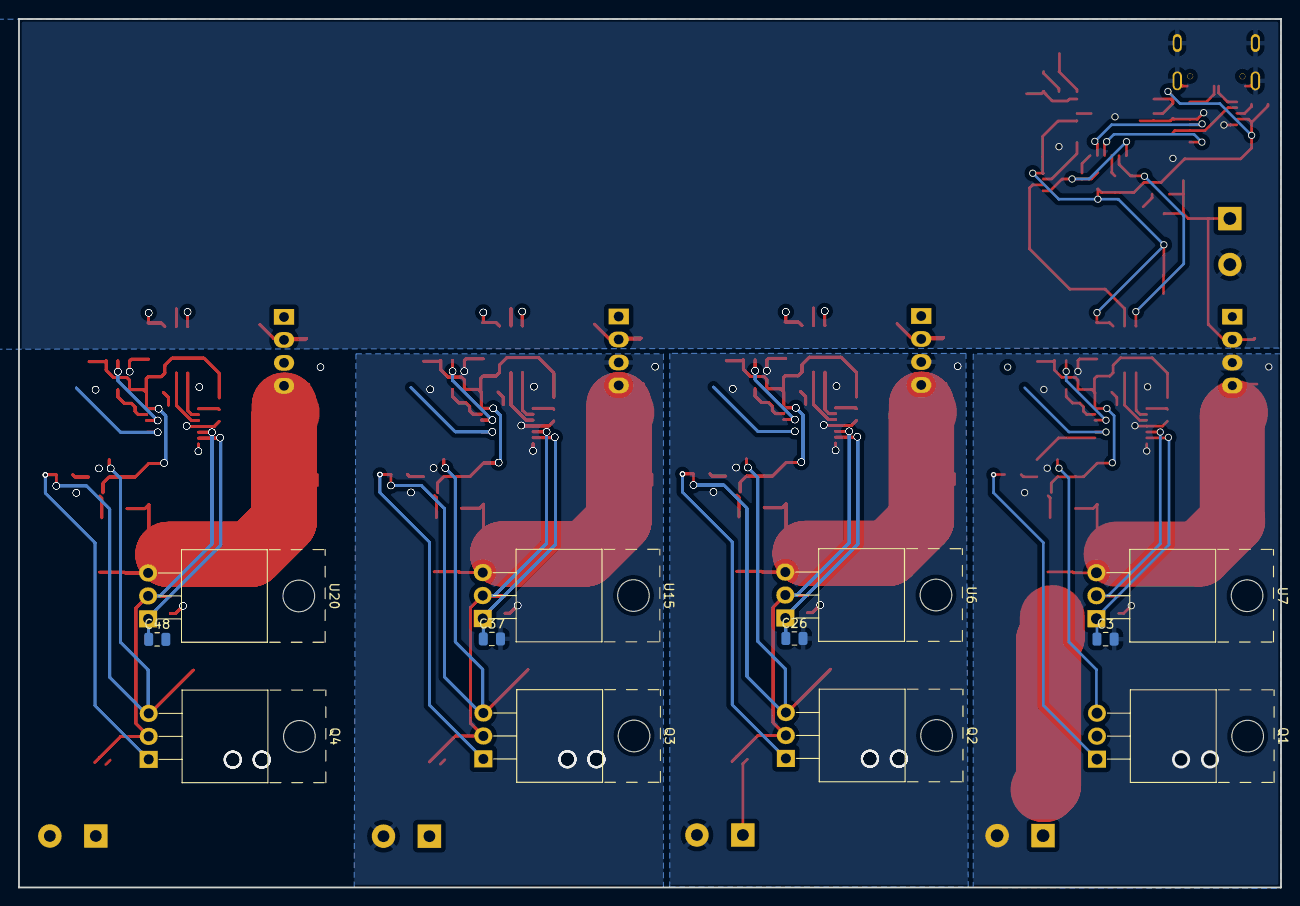
[picture p60: board Battery_Emulator.kicad_pcb from below]

Board: 2 copper layers, 139.5 x 96.0 mm, 133 parts (12 on the bottom side), 80 nets.

Parts:
C1, C2, C3, C6, C7, C8, C9, C10, C11, C14, C15, C18, C19, C20, C21, C22, C23, C24, C26, C27, C29, C30, C31, C32, C33, C34, C35, C37, C38, C40, C41, C42, C43, C44, C45, C46, C48, C49, C51, C52, C53, C54, C55: 100n; C_0805_2012Metric
C4, C5: 22p; C_0805_2012Metric
C12, C13, C16, C17, C25, C28, C36, C39, C47, C50: 10u; C_0805_2012Metric
J1: Vin; TerminalBlock_Phoenix_MKDS-1,5-2-5.08_1x02_P5.08mm_Horizont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
J2: USB4105-GF-A-060; GCT_USB4105-GF-A-060
J3: Cell1_Vout; TerminalBlock_Phoenix_MKDS-1,5-2-5.08_1x02_P5.08mm_Horizont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
J4: Cell2_Vout; TerminalBlock_Phoenix_MKDS-1,5-2-5.08_1x02_P5.08mm_Horizont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
J5: Cell3_Vout; TerminalBlock_Phoenix_MKDS-1,5-2-5.08_1x02_P5.08mm_Horizont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
J6: Cell4_Vout; TerminalBlock_Phoenix_MKDS-1,5-2-5.08_1x02_P5.08mm_Horizont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
JP1, JP2, JP3, JP4, JP5, JP6, JP7, JP8, JP9, JP10, JP11, JP12: Jumper; SolderJumper-3_P1.3mm_Open_Pad1.0x1.5mm_NumberLabels
PS1, PS2, PS3, PS4: MEE1S1209SC; Converter_DCDC_Murata_MEE1SxxxxSC_THT
Q1, Q2, Q3, Q4: IRFB7545PBF; TO-220-3_Horizontal_TabUp
R1, R8, R11, R14: 780k; R_0805_2012Metric
R2, R10, R13, R16: 0.5m; R_2512_6332Metric
R3, R4, R5, R6: 10k; R_0805_2012Metric
R7, R9, R12, R15: 47; R_0805_2012Metric
TP1: 5V; TestPoint_Pad_D2.5mm
TP2, TP3, TP15, TP19: 5V_ISO; TestPoint_Pad_D2.5mm
TP4, TP5, TP14, TP18: 9V_ISO; TestPoint_Pad_D2.5mm
TP10: GND; TestPoint_Pad_D2.5mm
TP11: 12V; TestPoint_Pad_D2.5mm
U1, U12, U17, U22: MCP4651T-103E_ST; TSSOP-14_4.4x5mm_P0.65mm
U2, U11, U16, U21: ISO1640BDR; SO-8_3.9x4.9mm_P1.27mm
U3: 74AHC2G125DP,125; TSSOP-8_3x3mm_P0.65mm
U4: FT230XS-R; SSOP-16_3.9x4.9mm_P0.635mm
U5, U9, U13, U18, U23: KA78M05_TO252; TO-252-2
U6, U7, U15, U20: LM317_TO-220; TO-220-3_Horizontal_TabUp
U8, U14, U19, U24: MCP6001UT-I/OT; SOT-23-5
U10: ATmega328PB-A; TQFP-32_7x7mm_P0.8mm
Y1: Crystal_GND24; Crystal_SMD_3225-4Pin_3.2x2.5mm

Connections:
+5V: C8.1, C9.1, C12.1, C14.1, C18.2, C21.1, C22.1, C24.2, C35.2, C46.2, R3.1, R4.1, R5.1, R6.1, TP1.1, U2.1 (VCC1), U3.8 (Vcc), U4.12 (VCC), U9.3 (VO), U10.4 (VCC), U10.18 (AVCC), U10.20 (AREF), U11.1 (VCC1), U16.1 (VCC1), U21.1 (VCC1)
+12V: C10.1, C13.1, C17.1, C25.1, C36.1, C47.1, J1.1, PS1.2 (+Vin), PS2.2 (+Vin), PS3.2 (+Vin), PS4.2 (+Vin), TP11.1, U9.1 (VI)
/Cell_1/+5V_ISO: C2.1, C15.1, C19.1, C20.1, JP1.3 (B), JP2.3 (B), JP3.3 (B), R1.1, TP2.1, U1.14 (VDD), U2.8 (VCC2), U5.3 (VO), U8.5 (Vdd)
/Cell_1/+9V_ISO: C1.1, C6.1, C16.1, PS1.4 (+Vout), TP4.1, U5.1 (VI), U7.3 (VI)
/Cell_1/A0: JP1.2 (C), U1.1 (HVC/A0)
/Cell_1/A1: JP2.2 (C), U1.13 (A1)
/Cell_1/A2: JP3.2 (C), U1.12 (A2)
/Cell_1/GND_ISO: C1.2, C2.2, C3.2, C6.2, C7.2, C15.2, C16.2, C19.2, C20.2, J3.2, JP1.1 (A), JP2.1 (A), JP3.1 (A), PS1.3 (-Vout), R2.2, U1.4 (VSS), U1.7 (P1A), U1.8 (P0A), U2.5 (GND2), U5.2 (GND), U8.2 (Vss)
/Cell_1/SCL_ISO: U1.2 (SCL), U2.6 (SCL2)
/Cell_1/SDA_ISO: U1.3 (SDA), U2.7 (SDA2)
/Cell_2/+5V_ISO: C29.1, C31.1, C32.1, C33.1, JP4.3 (B), JP5.3 (B), JP6.3 (B), R8.1, TP3.1, U11.8 (VCC2), U12.14 (VDD), U13.3 (VO), U14.5 (Vdd)
/Cell_2/+9V_ISO: C23.1, C28.1, C30.1, PS2.4 (+Vout), TP5.1, U6.3 (VI), U13.1 (VI)
/Cell_2/A0: JP4.2 (C), U12.1 (HVC/A0)
/Cell_2/A1: JP5.2 (C), U12.13 (A1)
/Cell_2/A2: JP6.2 (C), U12.12 (A2)
/Cell_2/COUT+: C27.1, J4.1, Q2.2, U6.2 (VO), U12.5 (P1B)
/Cell_2/GND_ISO: C23.2, C26.2, C27.2, C28.2, C29.2, C30.2, C31.2, C32.2, C33.2, J4.2, JP4.1 (A), JP5.1 (A), JP6.1 (A), PS2.3 (-Vout), R10.2, U11.5 (GND2), U12.4 (VSS), U12.7 (P1A), U12.8 (P0A), U13.2 (GND), U14.2 (Vss)
/Cell_2/SCL_ISO: U11.6 (SCL2), U12.2 (SCL)
/Cell_2/SDA_ISO: U11.7 (SDA2), U12.3 (SDA)
/Cell_3/+5V_ISO: C40.1, C42.1, C43.1, C44.1, JP7.3 (B), JP8.3 (B), JP9.3 (B), R11.1, TP15.1, U16.8 (VCC2), U17.14 (VDD), U18.3 (VO), U19.5 (Vdd)
/Cell_3/+9V_ISO: C34.1, C39.1, C41.1, PS3.4 (+Vout), TP14.1, U15.3 (VI), U18.1 (VI)
/Cell_3/A0: JP7.2 (C), U17.1 (HVC/A0)
/Cell_3/A1: JP8.2 (C), U17.13 (A1)
/Cell_3/A2: JP9.2 (C), U17.12 (A2)
/Cell_3/COUT+: C38.1, J5.1, Q3.2, U15.2 (VO), U17.5 (P1B)
/Cell_3/GND_ISO: C34.2, C37.2, C38.2, C39.2, C40.2, C41.2, C42.2, C43.2, C44.2, J5.2, JP7.1 (A), JP8.1 (A), JP9.1 (A), PS3.3 (-Vout), R13.2, U16.5 (GND2), U17.4 (VSS), U17.7 (P1A), U17.8 (P0A), U18.2 (GND), U19.2 (Vss)
/Cell_3/SCL_ISO: U16.6 (SCL2), U17.2 (SCL)
/Cell_3/SDA_ISO: U16.7 (SDA2), U17.3 (SDA)
/Cell_4/+5V_ISO: C51.1, C53.1, C54.1, C55.1, JP10.3 (B), JP11.3 (B), JP12.3 (B), R14.1, TP19.1, U21.8 (VCC2), U22.14 (VDD), U23.3 (VO), U24.5 (Vdd)
/Cell_4/+9V_ISO: C45.1, C50.1, C52.1, PS4.4 (+Vout), TP18.1, U20.3 (VI), U23.1 (VI)
/Cell_4/A0: JP10.2 (C), U22.1 (HVC/A0)
/Cell_4/A1: JP11.2 (C), U22.13 (A1)
/Cell_4/A2: JP12.2 (C), U22.12 (A2)
/Cell_4/COUT+: C49.1, J6.1, Q4.2, U20.2 (VO), U22.5 (P1B)
/Cell_4/GND_ISO: C45.2, C48.2, C49.2, C50.2, C51.2, C52.2, C53.2, C54.2, C55.2, J6.2, JP10.1 (A), JP11.1 (A), JP12.1 (A), PS4.3 (-Vout), R16.2, U21.5 (GND2), U22.4 (VSS), U22.7 (P1A), U22.8 (P0A), U23.2 (GND), U24.2 (Vss)
/Cell_4/SCL_ISO: U21.6 (SCL2), U22.2 (SCL)
/Cell_4/SDA_ISO: U21.7 (SDA2), U22.3 (SDA)
/D+: J2.A6 (Dp1), U4.8 (USBDP)
/D-: J2.A7 (Dn1), U4.9 (USBDM)
/RX: U4.1 (TXD), U10.30 (PD0)
/SCL: R4.2, U2.3 (SCL1), U10.28 (PC5), U11.3 (SCL1), U16.3 (SCL1), U21.3 (SCL1)
/SDA: R3.2, U3.2, U3.5, U10.27 (PC4)
/SDA_cell_1-7: U2.2 (SDA1), U3.6, U11.2 (SDA1), U16.2 (SDA1), U21.2 (SDA1)
/TX: U4.4 (RXD), U10.31 (PD1)
GND: C4.2, C5.2, C8.2, C9.2, C10.2, C11.2, C12.2, C13.2, C14.2, C18.1, C21.2, C22.2, C24.1, C35.1, C46.1, J1.2, J2.GND, TP10.1, U2.4 (GND1), U3.4 (GND), U4.5 (GND), U4.13 (GND), U9.2 (GND), U10.5 (GND), U10.21 (GND), U11.4 (GND1), U16.4 (GND1), U21.4 (GND1), Y1.2, Y1.4
unnamed: C17.2, PS1.1 (-Vin)
unnamed: C25.2, PS2.1 (-Vin)
unnamed: C36.2, PS3.1 (-Vin)
unnamed: C47.2, PS4.1 (-Vin)
unnamed: Q1.1, R7.2
unnamed: Q2.1, R9.2
unnamed: Q3.1, R12.2
unnamed: Q4.1, R15.2
unnamed: R7.1, U8.1
unnamed: R9.1, U14.1
unnamed: R12.1, U19.1
unnamed: R15.1, U24.1
unnamed: R1.2, U1.10 (P0B)
unnamed: U1.9 (P0W), U8.3 (+)
unnamed: C3.1, U1.6 (P1W), U7.1 (ADJ)
unnamed: C11.1, U4.3 (VCCIO), U4.10 (3V3OUT)
unnamed: R6.2, U4.11 (RESET#)
unnamed: C7.1, J3.1, Q1.2, Q1.3, R2.1, U1.5 (P1B), U7.2 (VO), U8.4 (-)
unnamed: U3.1, U10.32 (PD2)
unnamed: U3.7, U10.1 (PD3)
unnamed: C5.1, U10.7 (XTAL1/PB6), Y1.3
unnamed: C4.1, U10.8 (XTAL2/PB7), Y1.1
unnamed: R5.2, U10.29 (~RESET/PC6)
unnamed: R8.2, U12.10 (P0B)
unnamed: U12.9 (P0W), U14.3 (+)
unnamed: C26.1, U6.1 (ADJ), U12.6 (P1W)
unnamed: Q2.3, R10.1, U14.4 (-)
unnamed: C37.1, U15.1 (ADJ), U17.6 (P1W)
unnamed: R11.2, U17.10 (P0B)
unnamed: U17.9 (P0W), U19.3 (+)
unnamed: Q3.3, R13.1, U19.4 (-)
unnamed: C48.1, U20.1 (ADJ), U22.6 (P1W)
unnamed: R14.2, U22.10 (P0B)
unnamed: U22.9 (P0W), U24.3 (+)
unnamed: Q4.3, R16.1, U24.4 (-)
