HeinVerhallen/Hardware_Simulator/(commit log)

2023-09-05 Update PoA
    Added planning in planning chapter and made it a landscape page such that the planning fits.
    Also created a new detailed planning in excel.
    [Planning Hardware emulator.xlsx]
2023-09-13 Update PoA
    added new part in project result chapter.
    Made functional and non-functional requirements in excel document.
    [Functional and non-functional requirements.xlsx]
2023-09-19 Created updated broad planning
    [Broad planning.xlsx]
2023-09-20 Update PoA
    [Functional and non-functional requirements.xlsx]
2023-09-20 Update PoA
    Updated broad planning. Included requirements and broad planning in latex as image
    [Broad planning.xlsx]
2023-09-20 Changed file structure in Documentation folder
    [Functional and non-functional requirements.xlsx]
2023-09-27 Update broad planning
    [Broad planning.xlsx]
2023-09-27 Made pictures from battery cell diagram
2023-10-04 Created Battery Emulator Schematic
    [Battery_Emulator.kicad_pcb, Battery_Emulator.kicad_sch, Battery_Emulator.sch, Cell_1.kicad_sch]
2023-10-04 DC-motor updates
2023-10-04 configured custom symbols and footprints structure
2023-10-04 deleted old kicad version files
    [Battery_Emulator.sch]
2023-10-04 Created current sink simulation
2023-10-04 Added Cell Hierachy
    [Battery_Emulator.kicad_sch, Cell_1.kicad_sch]
2023-10-04 Added FT230XS-R
    [Battery_Emulator.kicad_sch]
2023-10-11 Added USB-C and Crystal Components
    Symbols + Footprints
    [Battery_Emulator.kicad_sch]
2023-10-11 Created avr-i2c-library
2023-10-11 Added ATMega and fixed isolated voltage level
    12V_ISO -> 9V_ISO
    [Battery_Emulator.kicad_sch, Cell_1.kicad_sch]
2023-10-11 Inputted all components and values
    [Battery_Emulator.kicad_sch, Cell_1.kicad_sch]
2023-10-11 small move of a gnd
    [Battery_Emulator.kicad_sch]
2023-10-25 Updated schematic battery emulator
    Made schematic more clear. Fixed some bugs
    [Battery_Emulator.kicad_sch, Cell_1.kicad_sch]
2023-10-25 wrote code for voltage level setting
2023-11-01 Added components to PCB and started the layout
    Also added footprints for the pots, jumpers and power connector
    [Battery_Emulator.kicad_pcb, Battery_Emulator.kicad_sch, Cell_1.kicad_sch]
2023-11-01 Update PCB
    Made PCB in Kicad
    [Battery_Emulator.kicad_pcb, Battery_Emulator.kicad_sch, Cell_1.kicad_sch]
2023-11-01 Update PCB design
    [Battery_Emulator.kicad_pcb, Battery_Emulator.kicad_sch, Cell_1.kicad_sch]
2023-11-01 Worked on current sink simulations in order to improve stability
2023-11-01 Update PCB
    Made traces a lot larger to pass more current.
    Added resistor to gate of current sink MOSFET.
    Made the gerber files and ordered it at SMD lab.
    [Battery_Emulator.kicad_pcb, Cell_1.kicad_sch]
2023-11-02 Update PCB
    Changed via hole sizes to 0.6mm so it can be made in SMD lab
    [Battery_Emulator.kicad_pcb]
2023-11-06 Added a second version of the hardware
    [Battery_Emulator.kicad_pcb, Battery_Emulator.kicad_sch, Cell_1.kicad_sch]
2023-11-06 Modified the v2 pcb
    [Battery_Emulator.kicad_sch, Cell_1.kicad_sch]
2023-11-06 Update PCB
    Updated the via sizes to 0.8mm in v1
    [Battery_Emulator.kicad_pcb]
2023-11-07 PCB-update for production
    [Battery_Emulator.kicad_pcb]
2023-11-15 Hardware Update
    V2 with four cells with the same layout
    [Battery_Emulator.kicad_pcb, Battery_Emulator.kicad_sch, Cell_1.kicad_sch]
2023-11-15 Linear regulator simulations addidions and cleanup
2023-11-15 Hardware Update
    Made a v3 that has a model board PCB and a cell board PCB. Made both schematics and started on the layout of the model board PCB.
    [Battery_Emulator_Cell_Board.kicad_pcb, Battery_Emulator_Cell_Board.kicad_sch, Battery_Emulator_Model_Board.kicad_pcb, Battery_Emulator_Model_Board.kicad_sch]
2023-11-22 Hardware Update
    Updated the v3 model board PCB layout.
    [Battery_Emulator_Model_Board.kicad_pcb]
2023-11-22 Hardware Update
    Finished the Model Board PCB
    [Battery_Emulator_Model_Board.kicad_pcb, Battery_Emulator_Model_Board.kicad_sch]
2023-11-22 added ESR resistance for stabililty
2023-11-22 Hardware update
    updated the model board pcb and the cell pcb
    [Battery_Emulator_Cell_Board.kicad_pcb, Battery_Emulator_Model_Board.kicad_pcb]
2023-11-22 Added new lin-reg topology. Use this LT3080-1 schematic for the design
2023-11-22 Update battery emulator v3 design
    Updated design such that its is parallel with the pins
    [Battery_Emulator_Model_Board.kicad_pcb]
2023-11-23 Updated mother board + cell PCB
    Made +12V trace on mother board 2mm so it can withstand 2A. Improved routing a bit. Changed pinheader to pinsocket on motherboard and pinsocket to pinheader on cell PCB. Mother board is nearly finished, Cell PCB is not finished.
    [Battery_Emulator_Cell_Board.kicad_pcb, Battery_Emulator_Cell_Board.kicad_sch, Battery_Emulator_Model_Board.kicad_pcb, Battery_Emulator_Model_Board.kicad_sch]
2023-11-27 Updated model board a bit after review
    [Battery_Emulator_Model_Board.kicad_pcb]
2023-11-29 Updated Mother board and Cell board
    Changed pinout of mother board and cell board such that the pin headers are on the top side. Finished mother board PCB and did DRC check on it.
    [Battery_Emulator_Cell_Board.kicad_pcb, Battery_Emulator_Cell_Board.kicad_sch, Battery_Emulator_Model_Board.kicad_pcb, Battery_Emulator_Model_Board.kicad_sch]
2023-11-29 Hardware Update
    Added the symbols for the LT3080, and the transistor
    [Battery_Emulator_Cell_Board.kicad_sch]
2023-11-29 added current sink control
2023-11-29 added reverse polarity protection
    [Battery_Emulator_Model_Board.kicad_sch]
2023-11-29 Update Cell emulator PCB
    [Battery_Emulator_Cell_Board.kicad_pcb]
2023-11-29 Hardware Update
    Updated the layout of the cell board PCB
    [Battery_Emulator_Cell_Board.kicad_pcb, Battery_Emulator_Cell_Board.kicad_sch]
2023-11-29 added diode
    [Battery_Emulator_Model_Board.kicad_pcb, Battery_Emulator_Model_Board.kicad_sch]
2023-11-29 added current sink resistor
    [Battery_Emulator_Cell_Board.kicad_pcb, Battery_Emulator_Cell_Board.kicad_sch]
2023-12-06 update schematic
    [Battery_Emulator_Cell_Board.kicad_sch]
2023-12-06 Hardware update
    Updated the size of the model board, so that it has 65mm of space for each cell board.
    [Battery_Emulator_Model_Board.kicad_pcb]
2023-12-06 Hardware update
    Moved some of the ground vias
    [Battery_Emulator_Model_Board.kicad_pcb]
2023-12-06 Update Cell board
    Finished PCB layout design.
    Added two capacitors in schematic for stable feedback network for current sink.
    [Battery_Emulator_Cell_Board.kicad_pcb, Battery_Emulator_Cell_Board.kicad_sch]
2023-12-06 Generated Gerber files
    Generated gerber and drill files for mother board and cell board.
    [Battery_Emulator_Cell_Board.kicad_pcb, Battery_Emulator_Model_Board.kicad_pcb]
2023-12-20 Poster/BOM
    I added info to the poster and the order forms
    [BMS_Battery_Emulator_OrderForm1_23-10-2023.xlsm, BMS_Battery_Emulator_OrderForm2_8-12-2023.xlsm]
2024-01-10 Update Final_Poster_Presentation.pptx
    Replaced the word model board with mother board
2024-01-23 Firmware update
    Added a second wiper write. probably wrongly?
    [main.cpp]
2024-01-25 Added text for the PCB design and some more
2024-01-25 Moved images to appendix and updated PCBA screenshots to pictures
2024-01-25 Added the forgotten image of the PM and GM of the current sink and refered to it in the text
2024-01-30 Documentation Update
    [TestPlan.xlsx]
2024-01-30 Documentation Update
    Added the test table
    [TestPlan.xlsx]
